SuperDuu/samsung-robot-2026/hardware/CAD/GB37.SLDPRT

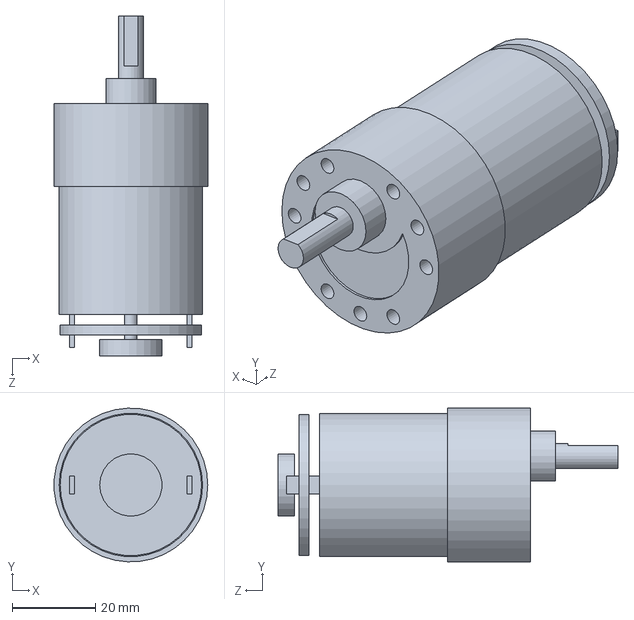
[picture p1: CAD file, 2026-10-31]
hardware/CAD/GB37.SLDPRT
36.9 x 37.0 x 81.8 mm
