SuperDuu/samsung-robot-2026/hardware/PCB/LINE_BOARD/uerlib/LIB_RPR-220/RPR-220/3D/RPR-220.stp

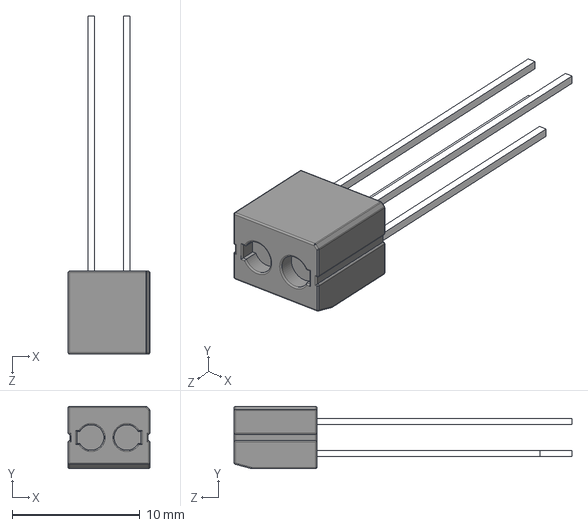
[picture p2: CAD file, 2026-10-31]
hardware/PCB/LINE_BOARD/uerlib/LIB_RPR-220/RPR-220/3D/RPR-220.stp
6.40 x 4.90 x 26.5 mm
