SuperDuu/samsung-robot-2026/hardware/CAD/Ga_GB37.SLDPRT

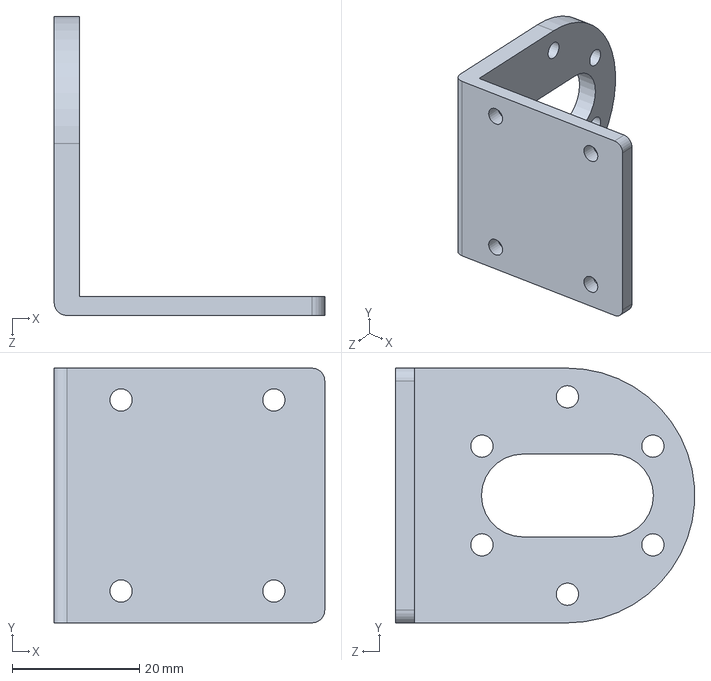
[picture p3: CAD file, 2026-10-31]
hardware/CAD/Ga_GB37.SLDPRT
42.5 x 40.0 x 47.0 mm
