SuperDuu/samsung-robot-2026/hardware/CAD/Onmi_58mm_OK.SLDPRT

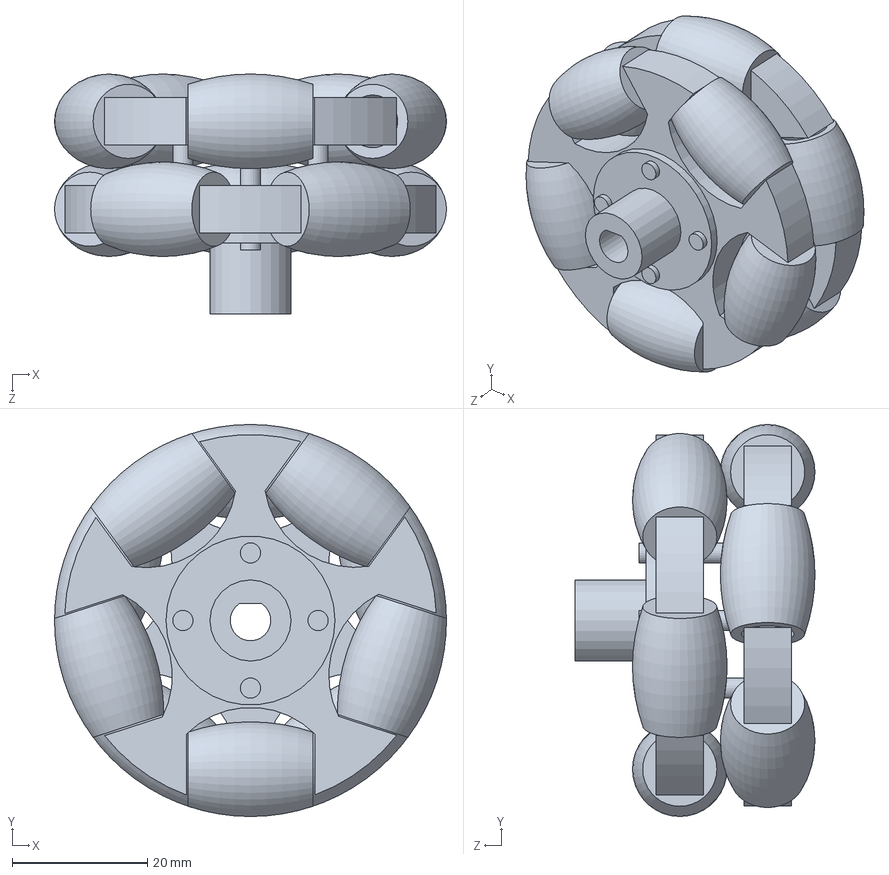
[picture p4: CAD file, 2026-10-31]
hardware/CAD/Onmi_58mm_OK.SLDPRT
58.0 x 58.0 x 35.5 mm
