SuperDuu/samsung-robot-2026/(list of files, cad)

Other CAD files:
hardware/LINE_BOARD/uerlib/LIB_RPR-220/RPR-220/Allegro/rpr220.psm
hardware/LINE_BOARD/uerlib/LIB_RPR-220/RPR-220/DEHDL/rpr_220/chips/chips.prt
hardware/PCB/LINE_BOARD/uerlib/LIB_RPR-220/RPR-220/DEHDL/rpr_220/chips/chips.prt
