SuperDuu/samsung-robot-2026/hardware/PCB/MainRB/MainRB.kicad_pcb

## KiCad design hardware/PCB/MainRB/MainRB.kicad_pcb (2026-10-31)

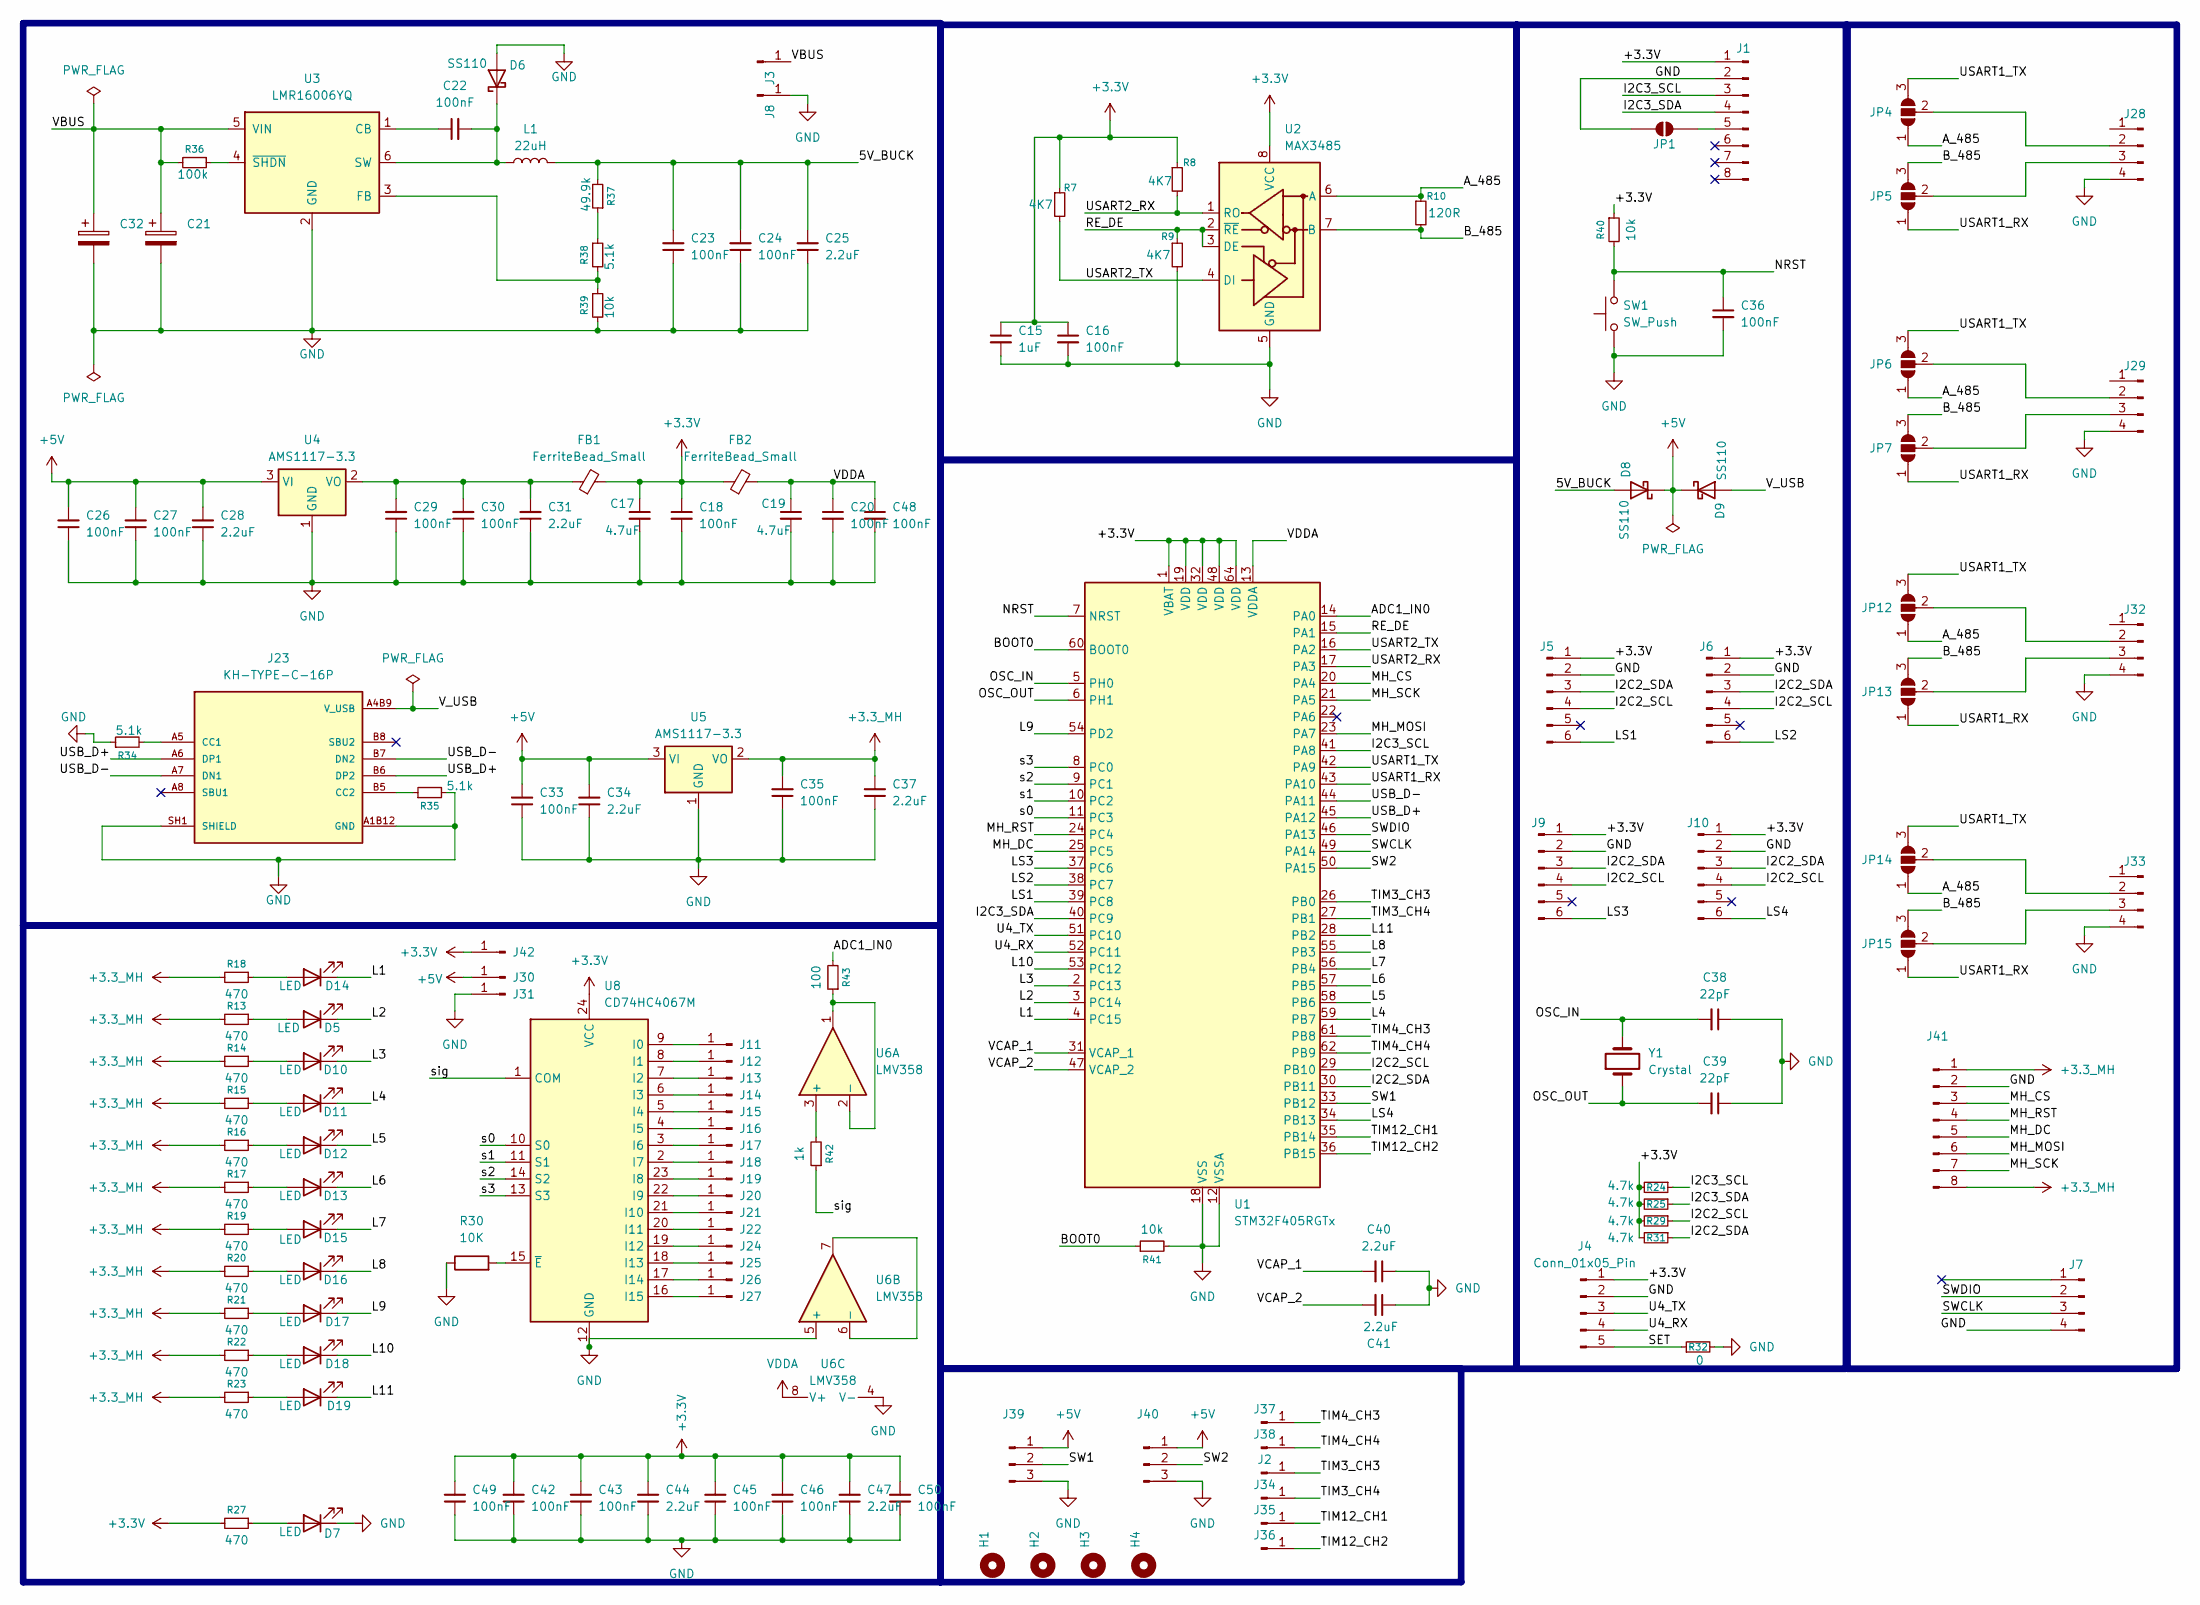
[picture p5: schematic MainRB.kicad_sch]

Parts:
C15: 1uF; C_0805_2012Metric_Pad1.18x1.45mm_HandSolder
C16, C18, C20, C22, C23, C24, C26, C27, C29, C30, C33, C35, C36, C42, C43, C45, C46, C48, C49, C50: 100nF; C_0805_2012Metric_Pad1.18x1.45mm_HandSolder
C17, C19: 4.7uF; C_0805_2012Metric_Pad1.18x1.45mm_HandSolder
C21, C32: C_Polarized; CP_Elec_10x10.5
C25, C28, C31, C34, C37, C40, C41, C44, C47: 2.2uF; C_0805_2012Metric_Pad1.18x1.45mm_HandSolder
C38, C39: 22pF; C_0805_2012Metric_Pad1.18x1.45mm_HandSolder
D5, D7, D10, D11, D12, D13, D14, D15, D16, D17, D18, D19: LED; LED_0805_2012Metric
D6, D8, D9: SS110; D_SMA
FB1, FB2: FerriteBead_Small; L_0603_1608Metric_Pad1.05x0.95mm_HandSolder
H1, H2, H3, H4: MountingHole; MountingHole_3.2mm_M3_ISO14580_Pad_TopBottom
J1: Conn_01x08_Pin; PinHeader_1x08_P2.54mm_Vertical
J2, J34, J35, J36, J37, J38: Conn_01x01_Pin; SolderWirePad_1x01_SMD_2x4mm
J3, J8: 24V_IN; SolderWirePad_1x01_SMD_4x8mm
J4: Conn_01x05_Pin; PinHeader_1x05_P2.54mm_Vertical
J5, J6, J9, J10: Conn_01x06_Pin; JST_XH_S6B-XH-A_1x06_P2.50mm_Horizontal
J7: Conn_01x04_Pin; JST_XH_B4B-XH-A_1x04_P2.50mm_Vertical
J11, J12, J13, J14, J15, J16, J17, J18, J19, J20, J21, J22, J24, J25, J26, J27, J30, J31, J42: Conn_01x01_Pin; SolderWirePad_1x01_SMD_1x2mm
J23: KH-TYPE-C-16P; KINGHELM_KH-TYPE-C-16P; PARTREV A0
J28, J29, J32, J33: Conn_01x04_Pin; JST_XH_S4B-XH-A-1_1x04_P2.50mm_Horizontal
J39, J40: Conn_01x03_Pin; JST_XH_B3B-XH-A_1x03_P2.50mm_Vertical
J41: Conn_01x08_Pin; JST_XH_B8B-XH-A_1x08_P2.50mm_Vertical
JP1: SolderJumper_2_Open; SolderJumper-2_P1.3mm_Open_Pad1.0x1.5mm
JP4, JP5, JP6, JP7, JP12, JP13, JP14, JP15: SolderJumper_3_Open; SolderJumper-3_P1.3mm_Open_RoundedPad1.0x1.5mm_NumberLabels
L1: 22uH; L_TracoPower_TCK-047_5.2x5.8mm
R7, R8, R9: 4K7; R_0805_2012Metric_Pad1.20x1.40mm_HandSolder
R10: 120R; R_0805_2012Metric_Pad1.20x1.40mm_HandSolder
R13, R14, R15, R16, R17, R18, R19, R20, R21, R22, R23, R27: 470; R_0805_2012Metric
R24, R25, R29, R31: 4.7k; R_0805_2012Metric
R30: 10K; R_0805_2012Metric
R32: 0; R_0805_2012Metric
R34, R35, R38: 5.1k; R_0805_2012Metric
R36: 100k; R_0805_2012Metric
R37: 49.9k; R_0805_2012Metric
R39, R40, R41: 10k; R_0805_2012Metric
R42: 1k; R_0805_2012Metric
R43: 100; R_0805_2012Metric
SW1: SW_Push; SW_Tactile_SPST_NO_Straight_CK_PTS636Sx25SMTRLFS
U1: STM32F405RGTx; LQFP-64_10x10mm_P0.5mm
U2: MAX3485; SOIC-8_3.9x4.9mm_P1.27mm
U3: LMR16006YQ; SOT-23-6
U4, U5: AMS1117-3.3; SOT-223-3_TabPin2
U6: LMV358; SOIC-8_3.9x4.9mm_P1.27mm
U8: CD74HC4067M; SOIC-24W_7.5x15.4mm_P1.27mm
Y1: Crystal; Crystal_HC49-4H_Vertical

Connections:
+3.3V: C15.1, C16.1, C17.1, C18.1, C42.2, C43.2, C44.2, C45.2, C46.2, C47.2, C49.2, C50.2, FB1.2, FB2.1, J1.1, J4.1, J5.1, J6.1, J9.1, J10.1, J42.1 (Pin_1_1), R7.1, R8.1, R24.2, R25.2, R27.2, R29.2, R31.2, R40.1, U1.1 (VBAT), U1.19 (VDD), U1.32 (VDD), U1.48 (VDD), U1.64 (VDD), U2.8 (VCC), U8.24 (VCC)
+3.3_MH: C35.2, C37.2, J41.1, J41.8, R13.2, R14.2, R15.2, R16.2, R17.2, R18.2, R19.2, R20.2, R21.2, R22.2, R23.2, U5.2 (VO)
+5V: C26.2, C27.2, C28.2, C33.2, C34.2, D8.1 (K), D9.1 (K), J30.1 (Pin_1_1), J39.1, J40.1, U4.3 (VI), U5.3 (VI)
/5V_BUCK: C23.2, C24.2, C25.2, D8.2 (A), L1.2, R37.2
/ADC1_IN0: R43.2, U1.14 (PA0)
/A_485: JP4.1 (A), JP6.1 (A), JP12.1 (A), JP14.1 (A), R10.1, U2.6 (A)
/BOOT0: R41.1, U1.60 (BOOT0)
/B_485: JP5.3 (B), JP7.3 (B), JP13.3 (B), JP15.3 (B), R10.2, U2.7 (B)
/I2C2_SCL: J5.4, J6.4, J9.4, J10.4, R29.1, U1.29 (PB10)
/I2C2_SDA: J5.3, J6.3, J9.3, J10.3, R31.1, U1.30 (PB11)
/I2C3_SCL: J1.3, R24.1, U1.41 (PA8)
/I2C3_SDA: J1.4, R25.1, U1.40 (PC9)
/L1: D14.1 (K), U1.4 (PC15)
/L2: D5.1 (K), U1.3 (PC14)
/L3: D10.1 (K), U1.2 (PC13)
/L4: D11.1 (K), U1.59 (PB7)
/L5: D12.1 (K), U1.58 (PB6)
/L6: D13.1 (K), U1.57 (PB5)
/L7: D15.1 (K), U1.56 (PB4)
/L8: D16.1 (K), U1.55 (PB3)
/L9: D17.1 (K), U1.54 (PD2)
/L10: D18.1 (K), U1.53 (PC12)
/L11: D19.1 (K), U1.28 (PB2)
/LS1: J5.6, U1.39 (PC8)
/LS2: J6.6, U1.38 (PC7)
/LS3: J9.6, U1.37 (PC6)
/LS4: J10.6, U1.34 (PB13)
/MH_CS: J41.3, U1.20 (PA4)
/MH_DC: J41.5, U1.25 (PC5)
/MH_MOSI: J41.6, U1.23 (PA7)
/MH_RST: J41.4, U1.24 (PC4)
/MH_SCK: J41.7, U1.21 (PA5)
/NRST: C36.1, R40.2, SW1.2, U1.7 (NRST)
/OSC_IN: C38.2, U1.5 (PH0), Y1.2
/OSC_OUT: C39.2, U1.6 (PH1), Y1.1
/RE_DE: R9.1, U1.15 (PA1), U2.2 (~RE), U2.3 (DE)
/SET: J4.5, R32.1
/SW1: J39.2, U1.33 (PB12)
/SW2: J40.2, U1.50 (PA15)
/SWCLK: J7.3, U1.49 (PA14)
/SWDIO: J7.2, U1.46 (PA13)
/TIM3_CH3: J2.1 (Pin_1_1), U1.26 (PB0)
/TIM3_CH4: J34.1 (Pin_1_1), U1.27 (PB1)
/TIM4_CH3: J37.1 (Pin_1_1), U1.61 (PB8)
/TIM4_CH4: J38.1 (Pin_1_1), U1.62 (PB9)
/TIM12_CH1: J35.1 (Pin_1_1), U1.35 (PB14)
/TIM12_CH2: J36.1 (Pin_1_1), U1.36 (PB15)
/U4_RX: J4.4, U1.52 (PC11)
/U4_TX: J4.3, U1.51 (PC10)
/USART1_RX: JP5.1 (A), JP7.1 (A), JP13.1 (A), JP15.1 (A), U1.43 (PA10)
/USART1_TX: JP4.3 (B), JP6.3 (B), JP12.3 (B), JP14.3 (B), U1.42 (PA9)
/USART2_RX: R8.2, U1.17 (PA3), U2.1 (RO)
/USART2_TX: R7.2, U1.16 (PA2), U2.4 (DI)
/USB_D+: J23.A6 (DP1), J23.B6 (DP2), U1.45 (PA12)
/USB_D-: J23.A7 (DN1), J23.B7 (DN2), U1.44 (PA11)
/VBUS: C21.1, C32.1, J3.1 (Pin_1_1), R36.2, U3.5 (VIN)
/VCAP_1: C40.2, U1.31 (VCAP_1)
/VCAP_2: C41.2, U1.47 (VCAP_2)
/s0: U1.11 (PC3), U8.10 (S0)
/s1: U1.10 (PC2), U8.11 (S1)
/s2: U1.9 (PC1), U8.14 (S2)
/s3: U1.8 (PC0), U8.13 (S3)
/sig: R42.1, U8.1 (COM)
GND: C15.2, C16.2, C17.2, C18.2, C19.2, C20.2, C21.2, C23.1, C24.1, C25.1, C26.1, C27.1, C28.1, C29.1, C30.1, C31.1, C32.2, C33.1, C34.1, C35.1, C36.2, C37.1, C38.1, C39.1, C40.1, C41.1, C42.1, C43.1, C44.1, C45.1, C46.1, C47.1, C48.2, C49.1, C50.1, D6.2 (A), D7.1 (K), J1.2, J4.2, J5.2, J6.2, J7.4, J8.1 (Pin_1_1), J9.2, J10.2, J23.A1B12 (GND), J23.A12B1 (GND), J23.SH1 (SHIELD), J23.SH2 (SHIELD), J23.SH3 (SHIELD), J23.SH4 (SHIELD), J28.4, J29.4, J31.1 (Pin_1_1), J32.4, J33.4, J39.3, J40.3, J41.2, JP1.1 (A), R9.2, R30.1, R32.2, R34.1, R35.2, R39.2, R41.2, SW1.1, U1.12 (VSSA), U1.18 (VSS), U1.63 (VSS), U2.5 (GND), U3.2 (GND), U4.1 (GND), U5.1 (GND), U6.4 (V-), U6.5 (+), U8.12 (GND)
unnamed: D5.2 (A), R13.1
unnamed: C22.2, D6.1 (K), L1.1, U3.6 (SW)
unnamed: D7.2 (A), R27.1
unnamed: D10.2 (A), R14.1
unnamed: D11.2 (A), R15.1
unnamed: D12.2 (A), R16.1
unnamed: D13.2 (A), R17.1
unnamed: D14.2 (A), R18.1
unnamed: D15.2 (A), R19.1
unnamed: D16.2 (A), R20.1
unnamed: D17.2 (A), R21.1
unnamed: D18.2 (A), R22.1
unnamed: D19.2 (A), R23.1
unnamed: J1.5, JP1.2 (B)
unnamed: J11.1 (Pin_1_1), U8.9 (I0)
unnamed: J12.1 (Pin_1_1), U8.8 (I1)
unnamed: J13.1 (Pin_1_1), U8.7 (I2)
unnamed: J14.1 (Pin_1_1), U8.6 (I3)
unnamed: J15.1 (Pin_1_1), U8.5 (I4)
unnamed: J16.1 (Pin_1_1), U8.4 (I5)
unnamed: J17.1 (Pin_1_1), U8.3 (I6)
unnamed: J18.1 (Pin_1_1), U8.2 (I7)
unnamed: J19.1 (Pin_1_1), U8.23 (I8)
unnamed: J20.1 (Pin_1_1), U8.22 (I9)
unnamed: J21.1 (Pin_1_1), U8.21 (I10)
unnamed: J22.1 (Pin_1_1), U8.20 (I11)
unnamed: J23.A5 (CC1), R34.2
unnamed: J23.B5 (CC2), R35.1
unnamed: J24.1 (Pin_1_1), U8.19 (I12)
unnamed: J25.1 (Pin_1_1), U8.18 (I13)
unnamed: J26.1 (Pin_1_1), U8.17 (I14)
unnamed: J27.1 (Pin_1_1), U8.16 (I15)
unnamed: J28.2, JP4.2 (C)
unnamed: J28.3, JP5.2 (C)
unnamed: J29.2, JP6.2 (C)
unnamed: J29.3, JP7.2 (C)
unnamed: J32.2, JP12.2 (C)
unnamed: J32.3, JP13.2 (C)
unnamed: J33.2, JP14.2 (C)
unnamed: J33.3, JP15.2 (C)
unnamed: R37.1, R38.1
unnamed: C22.1, U3.1 (CB)
unnamed: R38.2, R39.1, U3.3 (FB)
unnamed: R36.1, U3.4 (~SHDN)
unnamed: C29.2, C30.2, C31.2, FB1.1, U4.2 (VO)
unnamed: R42.2, U6.3 (+)
unnamed: R43.1, U6.1, U6.2 (-)
unnamed: U6.6 (-), U6.7
unnamed: R30.2, U8.15 (~E)
VDDA: C19.1, C20.1, C48.1, FB2.2, U1.13 (VDDA), U6.8 (V+)
V_USB: D9.2 (A), J23.A4B9 (V_USB), J23.A9B4 (V_USB)

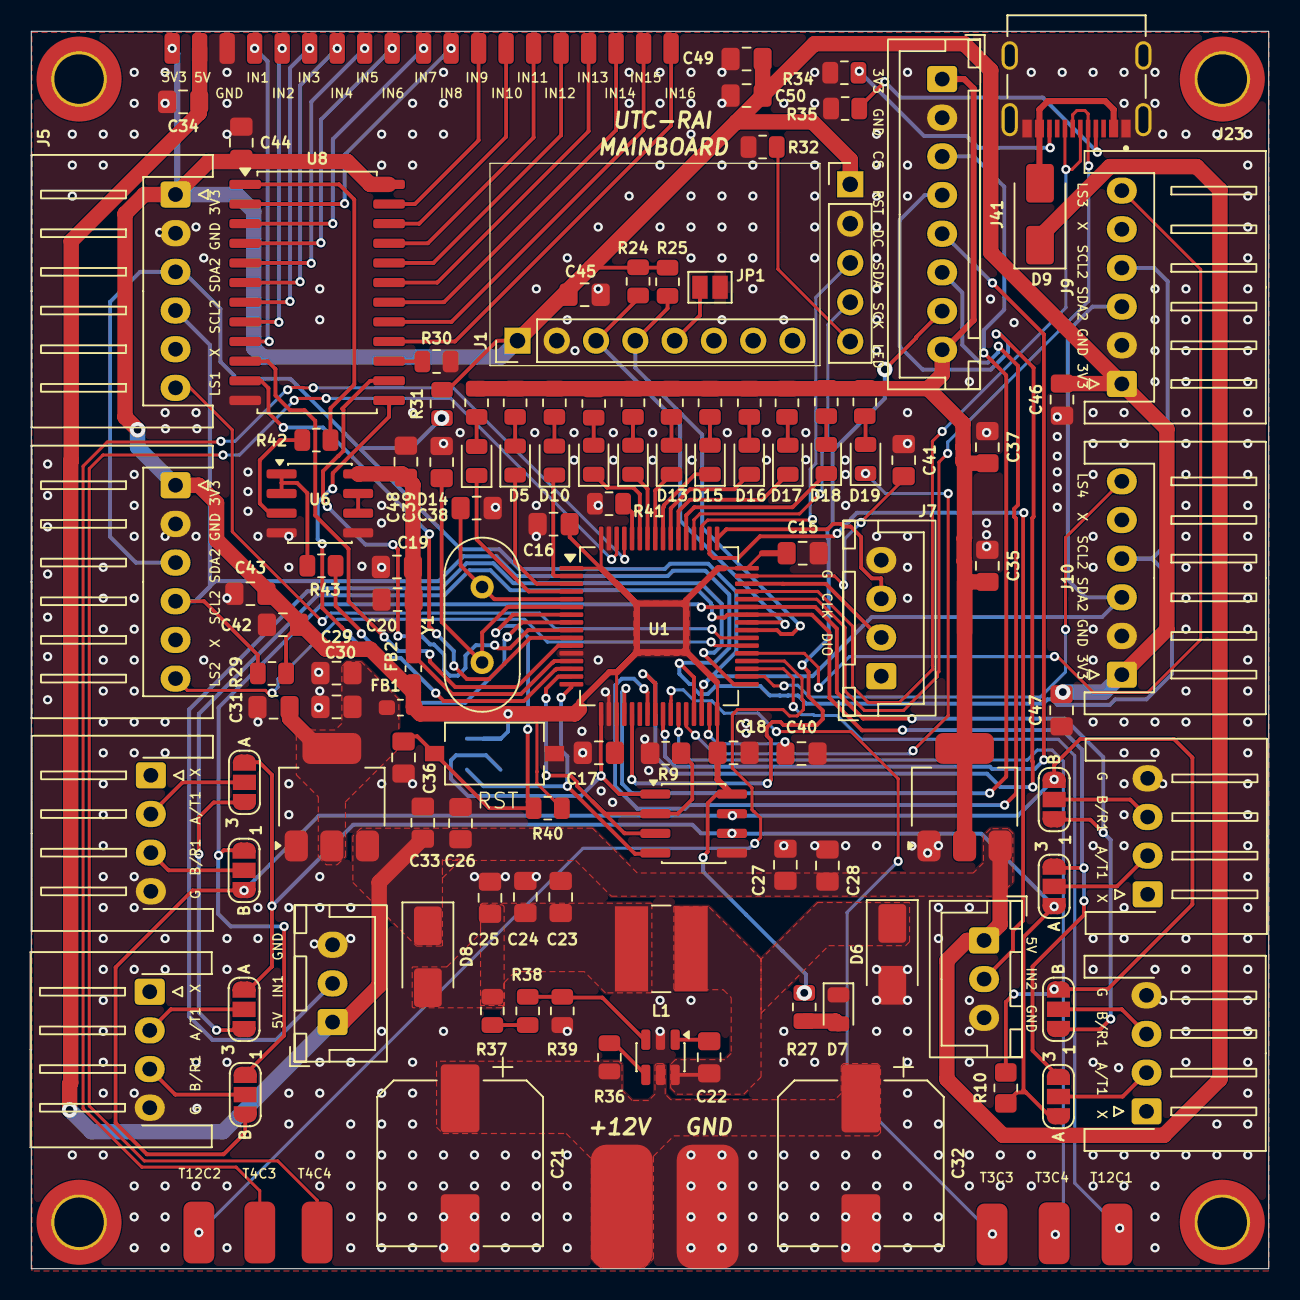
[picture p6: board MainRB.kicad_pcb from above]

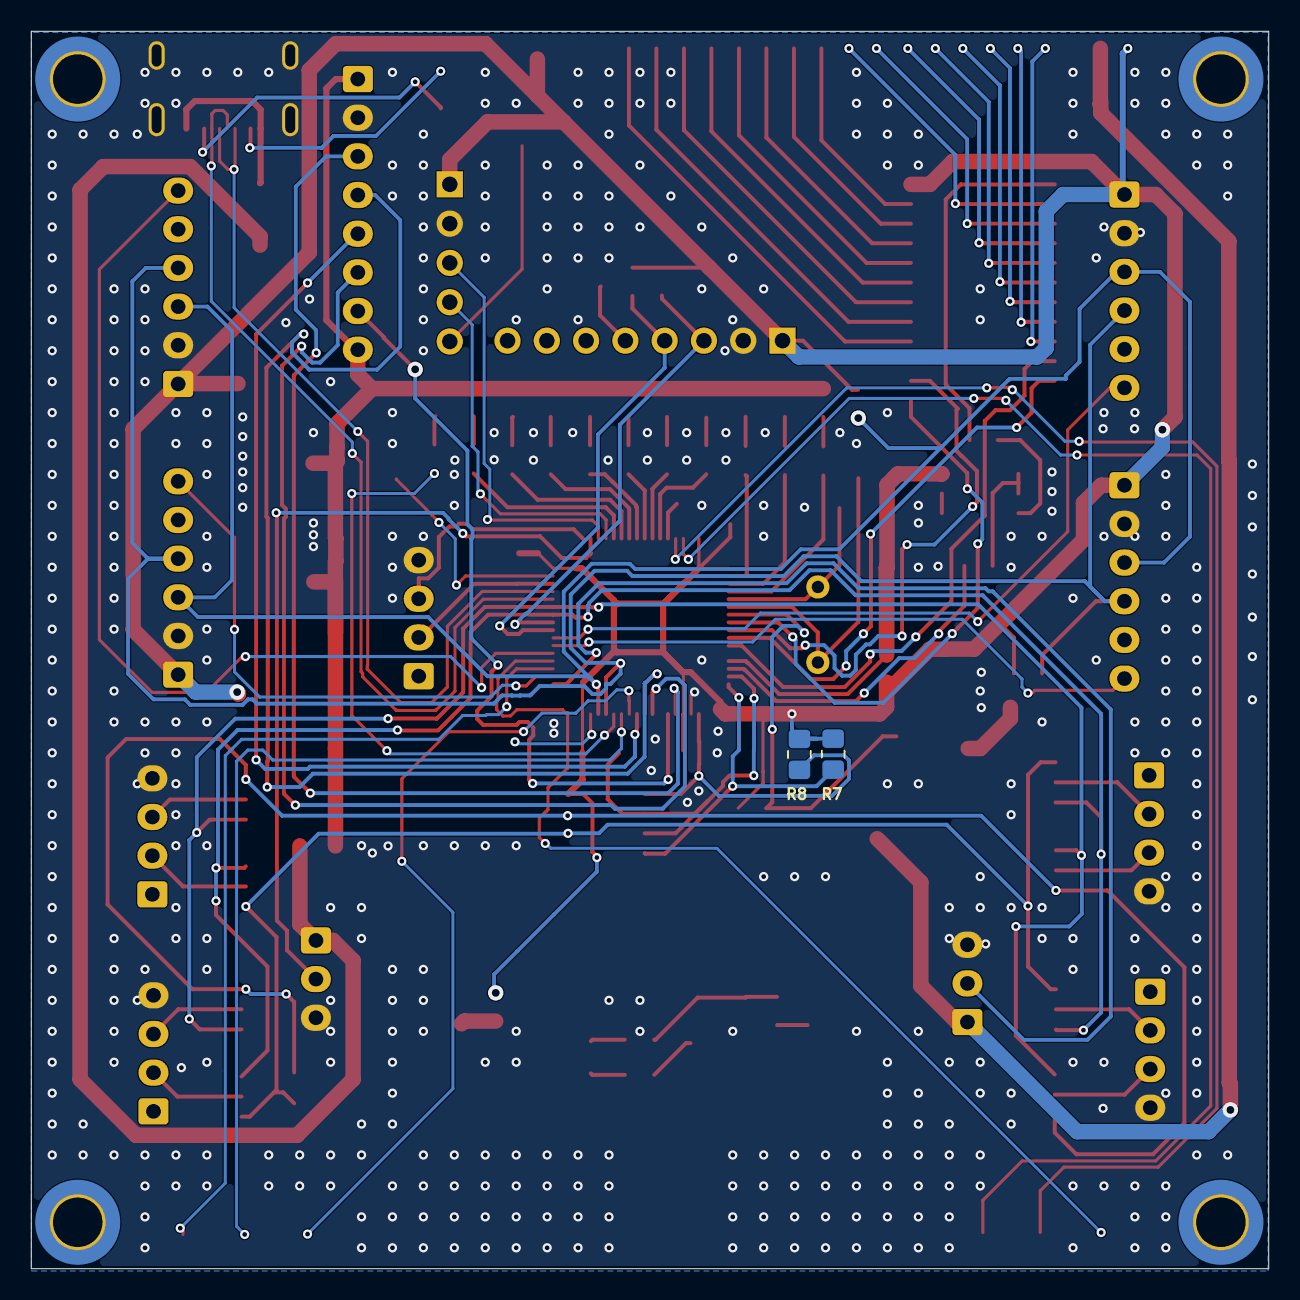
[picture p7: board MainRB.kicad_pcb from below]

Board: 2 copper layers, 80.0 x 80.0 mm, 150 parts (2 on the bottom side), 115 nets.
