SuperDuu/samsung-robot-2026/hardware/PCB/HB_RBC/HB_RBC.kicad_pcb

## KiCad design hardware/PCB/HB_RBC/HB_RBC.kicad_pcb (2026-10-31)

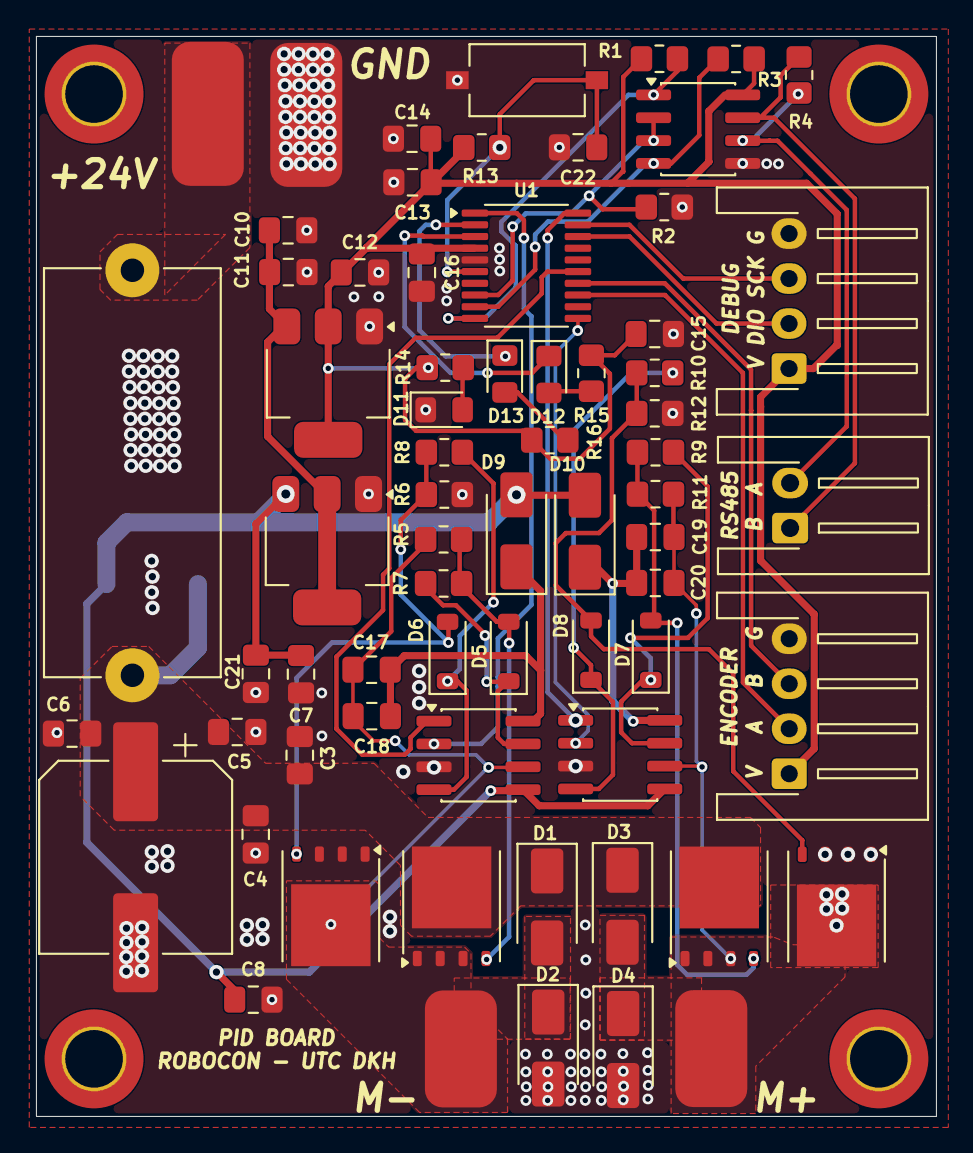
[picture p8: board HB_RBC.kicad_pcb from above]

Board: 2 copper layers, 50.0 x 60.0 mm, 73 parts (1 on the bottom side), 37 nets.

Parts:
C2: 50v_220uF; CP_Elec_10x10.5
C3, C7, C10, C12: 10uF; C_0805_2012Metric_Pad1.18x1.45mm_HandSolder
C4, C15, C17, C19: 1uF; C_0805_2012Metric_Pad1.18x1.45mm_HandSolder
C5, C6, C8, C11, C13, C14, C16, C18, C20, C21, C22: 100nF; C_0805_2012Metric_Pad1.18x1.45mm_HandSolder
D1: SS310; D_SMA
D2, D3, D4: D_Schottky; D_SMA
D5, D6, D7, D8: 1N4148W; D_SOD-123
D9, D10: SS110; D_SMA
D11, D12, D13: LED; LED_0805_2012Metric_Pad1.15x1.40mm_HandSolder
F1: Fuse; Fuseholder_Cylinder-5x20mm_Schurter_0031_8201_Horizontal_Op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
H1, H2, H3, H4: MountingHole; MountingHole_3.2mm_M3_ISO14580_Pad_TopBottom
J1: M+; SolderWirePad_1x01_SMD_4x8mm
J2: M-; SolderWirePad_1x01_SMD_4x8mm
J3: 24V_IN; SolderWirePad_1x01_SMD_4x8mm
J4: Conn_01x01_Pin; SolderWirePad_1x01_SMD_4x8mm
J5: Conn_01x02_Pin; JST_XH_S2B-XH-A-1_1x02_P2.50mm_Horizontal
J6, J7: Conn_01x04_Pin; JST_XH_S4B-XH-A-1_1x04_P2.50mm_Horizontal
Q1, Q2, Q3, Q4: BSC040N10NS5; TDSON-8-1
R1, R2, R3, R13: 4K7; R_0805_2012Metric_Pad1.20x1.40mm_HandSolder
R4: 120R; R_0805_2012Metric_Pad1.20x1.40mm_HandSolder
R5, R6, R11, R12: 1M; R_0805_2012Metric_Pad1.20x1.40mm_HandSolder
R7, R8, R9, R10: 10R; R_0805_2012Metric_Pad1.20x1.40mm_HandSolder
R14, R15, R16: 470; R_0805_2012Metric_Pad1.20x1.40mm_HandSolder
SW1: SW_Push; SW_Tactile_SPST_NO_Straight_CK_PTS636Sx25SMTRLFS
U1: STM32G030F6Px; TSSOP-20_4.4x6.5mm_P0.65mm
U2: MAX3485; SOIC-8_3.9x4.9mm_P1.27mm
U4: L7815; TO-263-3_TabPin2
U5: AMS1117-5.0; SOT-223-3_TabPin2
U6: AMS1117-3.3; SOT-223-3_TabPin2
U7, U8: IR2184; SOIC-8_3.9x4.9mm_P1.27mm

Connections:
+3.3V: C12.1, C13.1, C14.1, C15.1, C16.1, J6.1, J7.1, R1.1, R3.1, R13.1, R14.1, R15.1, R16.1, U1.4 (VDD), U2.8 (VCC), U6.2 (VO)
+5V: C10.1, C11.1, U5.2 (VO), U6.3 (VI)
+15V: C7.1, C8.1, C21.1, D9.2 (A), D10.2 (A), U4.3 (OUT), U5.3 (VI), U7.5 (VCC), U8.5 (VCC)
+24V: C2.1, C3.1, C4.1, C5.1, C6.1, D1.1 (K), D3.1 (K), F1.2, Q1.5 (D), Q4.5 (D), U4.1 (IN)
+24V_IN: F1.1, J3.1 (Pin_1_1)
/A: J6.2, U1.13 (PA6)
/A_485: J5.2, R4.1, U2.6 (A)
/B: J6.3, U1.14 (PA7)
/B_485: J5.1, R4.2, U2.7 (B)
/LED1: D12.1 (K), U1.3 (PC15)
/LED2: D13.1 (K), U1.2 (PB9/PC14)
/NRST: C22.1, R13.2, SW1.2, U1.6 (NRST)
/PWM_T1C1: U1.15 (PA8/PB0/PB1/PB2), U7.1 (IN)
/PWM_T1C2: U1.20 (PB3/PB4/PB5/PB6), U8.1 (IN)
/RE_DE: R2.1, U1.8 (PA1), U2.2 (~RE), U2.3 (DE)
/S: U1.1 (PB7/PB8), U7.2 (~SD)
/S2: U1.11 (PA4), U8.2 (~SD)
/SWCLK: J7.3, U1.19 (PA14/PA15)
/SWDIO: J7.2, U1.18 (PA13)
/U2_RX: R1.2, U1.10 (PA3), U2.1 (RO)
/U2_TX: R3.2, U1.9 (PA2), U2.4 (DI)
GND: C2.2, C3.2, C4.2, C5.2, C6.2, C7.2, C8.2, C10.2, C11.2, C12.2, C13.2, C14.2, C15.2, C16.2, C21.2, C22.2, D2.2 (A), D4.2 (A), D11.1 (K), J4.1 (Pin_1_1), J6.4, J7.4, Q2.1 (S), Q2.2 (S), Q2.3 (S), Q3.1 (S), Q3.2 (S), Q3.3 (S), R2.2, R6.2, R12.2, SW1.1, U1.5 (VSS), U2.5 (GND), U4.2 (GND), U5.1 (GND), U6.1 (GND), U7.3 (COM), U8.3 (COM)
unnamed: C17.2, C18.2, D1.2 (A), D2.1 (K), J2.1 (Pin_1_1), Q1.1 (S), Q1.2 (S), Q1.3 (S), Q2.5 (D), R5.2, U7.6 (VS)
unnamed: C19.2, C20.2, D3.2 (A), D4.1 (K), J1.1 (Pin_1_1), Q3.5 (D), Q4.1 (S), Q4.2 (S), Q4.3 (S), R11.2, U8.6 (VS)
unnamed: D5.2 (A), Q1.4 (G), R5.1, R7.2
unnamed: D5.1 (K), R7.1, U7.7 (HO)
unnamed: D6.2 (A), Q2.4 (G), R6.1, R8.2
unnamed: D6.1 (K), R8.1, U7.4 (LO)
unnamed: D7.2 (A), Q4.4 (G), R9.2, R11.1
unnamed: D7.1 (K), R9.1, U8.7 (HO)
unnamed: D8.2 (A), Q3.4 (G), R10.2, R12.1
unnamed: D8.1 (K), R10.1, U8.4 (LO)
unnamed: C17.1, C18.1, D9.1 (K), U7.8 (VB)
unnamed: C19.1, C20.1, D10.1 (K), U8.8 (VB)
unnamed: D11.2 (A), R14.2
unnamed: D12.2 (A), R15.2
unnamed: D13.2 (A), R16.2
