SuperDuu/samsung-robot-2026/hardware/LINE_BOARD/mach_do_line/mach_do_line.kicad_pcb

## KiCad design hardware/LINE_BOARD/mach_do_line/mach_do_line.kicad_pcb (2026-10-13)

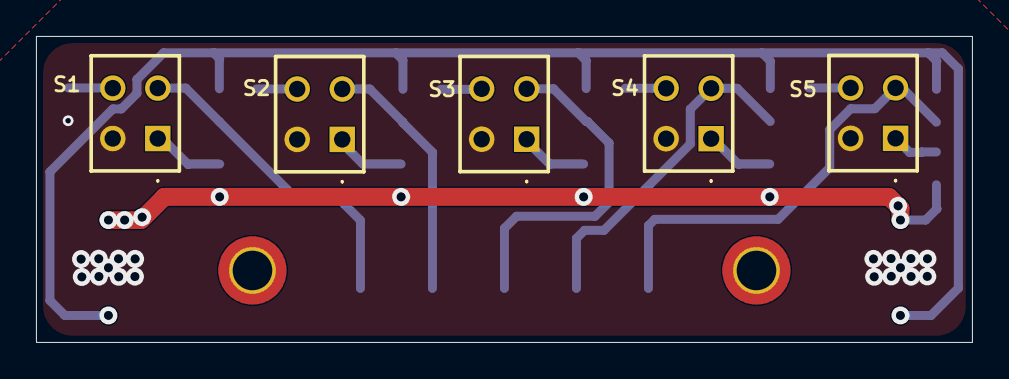
[picture p9: board mach_do_line.kicad_pcb from above]

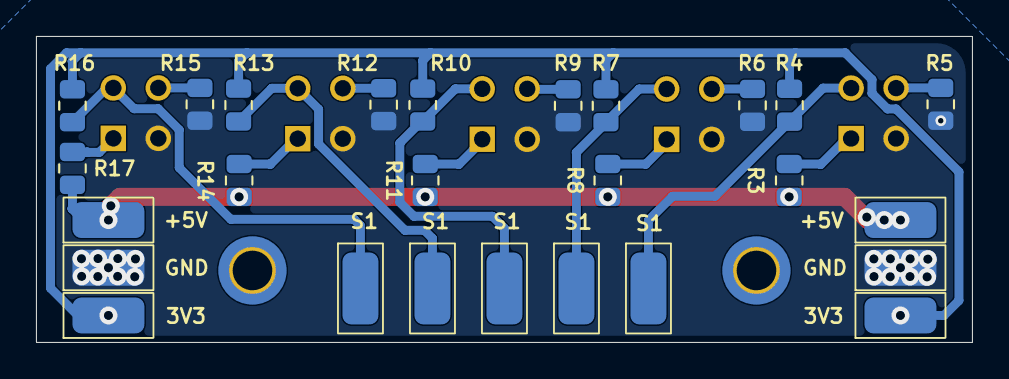
[picture p10: board mach_do_line.kicad_pcb from below]

Board: 2 copper layers, 52.0 x 17.0 mm, 33 parts (26 on the bottom side), 18 nets.

Parts:
3V3, 3V3#2: Conn_01x01_Pin; PAD-2x4mm-SMD
+5V, +5V#2: Conn_01x01_Pin; PAD-2x4mm-SMD
GND: Conn_01x01_Pin; PAD-2x4mm-SMD
GND#2: Conn_01x01_Pin; PAD-2x4mm-SMD
H1, H2: MountingHole; MountingHole_2.2mm_M2_ISO14580_Pad_TopBottom
J2, J10, J11, J12, J18: Conn_01x01_Pin; PAD-2x4mm-SMD
R3, R8, R11, R14, R17: 220R; R_0805_2012Metric
R4, R7, R10, R13, R16: 10K; R_0805_2012Metric
R5, R6, R9, R12, R15: 100R; R_0805_2012Metric
S1, S2, S3, S4, S5: RPR-220; RPR220

Connections:
+3V3: 3V3.1 (Pin_1_1), 3V3#2.1 (Pin_1_1), R4.2, R7.2, R10.2, R13.2, R16.2
+5V: +5V.1 (Pin_1_1), +5V#2.1 (Pin_1_1), R3.1, R8.1, R11.1, R14.1, R17.1
/s1: J2.1 (Pin_1_1), R4.1, S1.4 (C)
/s2: J10.1 (Pin_1_1), R7.1, S2.4 (C)
/s3: J11.1 (Pin_1_1), R10.1, S3.4 (C)
/s4: J12.1 (Pin_1_1), R13.1, S4.4 (C)
/s5: J18.1 (Pin_1_1), R16.1, S5.4 (C)
GND: GND.1 (Pin_1_1), GND#2.1 (Pin_1_1), R5.2, R6.2, R9.2, R12.2, R15.2, S1.2 (K), S2.2 (K), S3.2 (K), S4.2 (K), S5.2 (K)
unnamed: R3.2, S1.1 (A)
unnamed: R5.1, S1.3 (E)
unnamed: R8.2, S2.1 (A)
unnamed: R6.1, S2.3 (E)
unnamed: R11.2, S3.1 (A)
unnamed: R9.1, S3.3 (E)
unnamed: R14.2, S4.1 (A)
unnamed: R12.1, S4.3 (E)
unnamed: R17.2, S5.1 (A)
unnamed: R15.1, S5.3 (E)
