SuperDuu/samsung-robot-2026/MAIN_CONTROLLER/Indicator.kicad_sch

## KiCad design MAIN_CONTROLLER/Indicator.kicad_sch (2026-10-13)

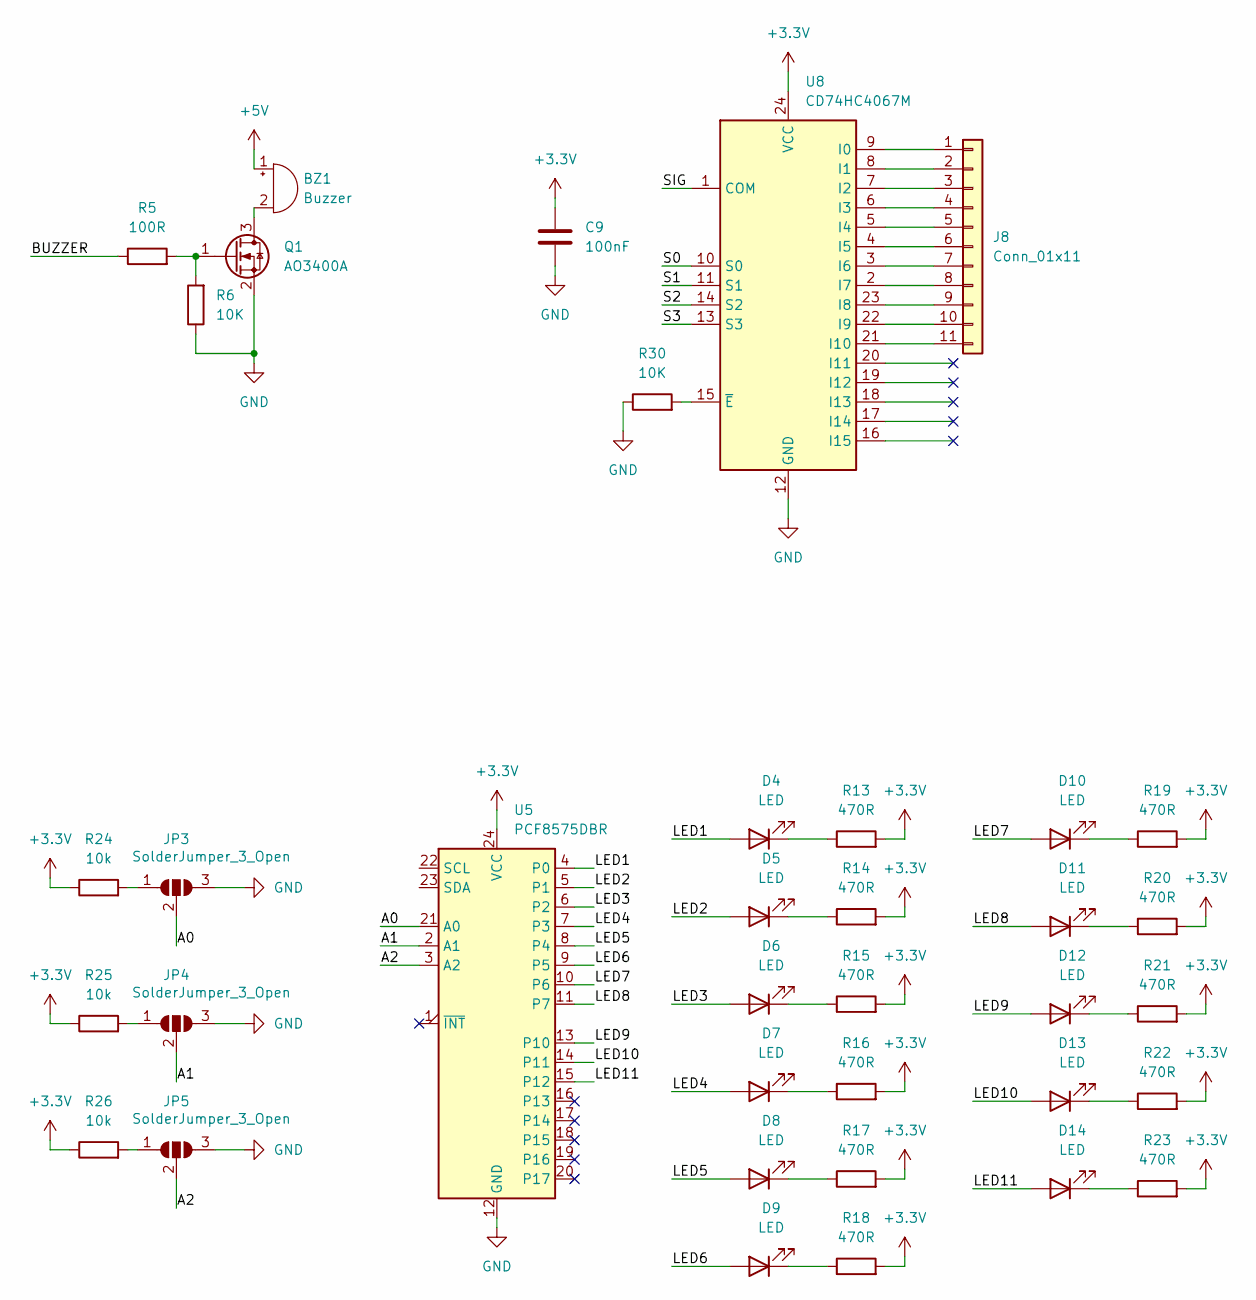
[picture p11: schematic Indicator.kicad_sch]

Parts:
BZ1: Buzzer
C9: 100nF
D4, D5, D6, D7, D8, D9, D10, D11, D12, D13, D14: LED
J8: Conn_01x11
JP3, JP4, JP5: SolderJumper_3_Open
Q1: AO3400A; SOT-23
R5: 100R
R6, R30: 10K
R13, R14, R15, R16, R17, R18, R19, R20, R21, R22, R23: 470R
R24, R25, R26: 10k
U5: PCF8575DBR; SSOP-24_5.3x8.2mm_P0.65mm
U8: CD74HC4067M; SOIC-24W_7.5x15.4mm_P1.27mm

Connections:
+3.3V: C9.1, R13.2, R14.2, R15.2, R16.2, R17.2, R18.2, R19.2, R20.2, R21.2, R22.2, R23.2, R24.1, R25.1, R26.1, U5.24 (VCC), U8.24 (VCC)
+5V: BZ1.1 (+)
A0: JP3.2 (C), U5.21 (A0)
A1: JP4.2 (C), U5.2 (A1)
A2: JP5.2 (C), U5.3 (A2)
BUZZER: R5.1
GND: C9.2, JP3.3 (B), JP4.3 (B), JP5.3 (B), Q1.2 (S), R6.1, R30.1, U5.12 (GND), U8.12 (GND)
LED1: D4.2 (A), U5.4 (P0)
LED2: D5.2 (A), U5.5 (P1)
LED3: D6.2 (A), U5.6 (P2)
LED4: D7.2 (A), U5.7 (P3)
LED5: D8.2 (A), U5.8 (P4)
LED6: D9.2 (A), U5.9 (P5)
LED7: D10.2 (A), U5.10 (P6)
LED8: D11.2 (A), U5.11 (P7)
LED9: D12.2 (A), U5.13 (P10)
LED10: D13.2 (A), U5.14 (P11)
LED11: D14.2 (A), U5.15 (P12)
unnamed: BZ1.2 (-), Q1.3 (D)
unnamed: D4.1 (K), R13.1
unnamed: D5.1 (K), R14.1
unnamed: D6.1 (K), R15.1
unnamed: D7.1 (K), R16.1
unnamed: D8.1 (K), R17.1
unnamed: D9.1 (K), R18.1
unnamed: D10.1 (K), R19.1
unnamed: D11.1 (K), R20.1
unnamed: D12.1 (K), R21.1
unnamed: D13.1 (K), R22.1
unnamed: D14.1 (K), R23.1
unnamed: J8.1, U8.9 (I0)
unnamed: J8.2, U8.8 (I1)
unnamed: J8.3, U8.7 (I2)
unnamed: J8.4, U8.6 (I3)
unnamed: J8.5, U8.5 (I4)
unnamed: J8.6, U8.4 (I5)
unnamed: J8.7, U8.3 (I6)
unnamed: J8.8, U8.2 (I7)
unnamed: J8.9, U8.23 (I8)
unnamed: J8.10, U8.22 (I9)
unnamed: J8.11, U8.21 (I10)
unnamed: JP3.1 (A), R24.2
unnamed: JP4.1 (A), R25.2
unnamed: JP5.1 (A), R26.2
unnamed: Q1.1 (G), R5.2, R6.2
unnamed: R30.2, U8.15 (~E)
S0: U8.10 (S0)
S1: U8.11 (S1)
S2: U8.14 (S2)
S3: U8.13 (S3)
SIG: U8.1 (COM)
