SuperDuu/samsung-robot-2026/hardware/MAIN_CONTROLLER/Power.kicad_sch

## KiCad design hardware/MAIN_CONTROLLER/Power.kicad_sch (2026-10-13)

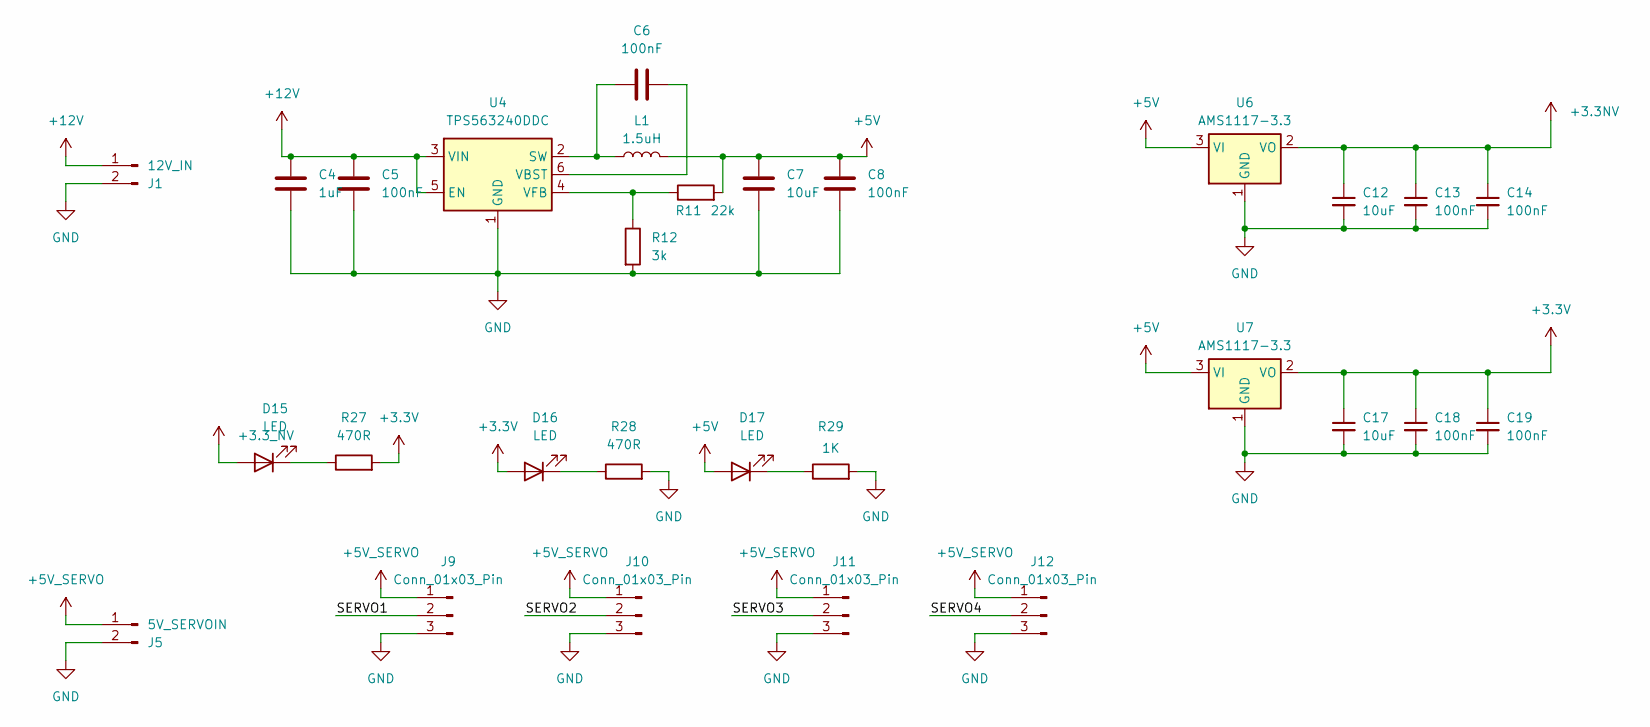
[picture p12: schematic Power.kicad_sch]

Parts:
C4: 1uF
C5, C6, C8: 100nF
C7: 10uF
C12, C17: 10uF; C_0805_2012Metric_Pad1.18x1.45mm_HandSolder
C13, C14, C18, C19: 100nF; C_0805_2012Metric_Pad1.18x1.45mm_HandSolder
D15, D16, D17: LED
J1: 12V_IN
J5: 5V_SERVOIN
J9, J10, J11, J12: Conn_01x03_Pin
L1: 1.5uH
R11: 22k
R12: 3k
R27, R28: 470R
R29: 1K
U4: TPS563240DDC; SOT-23-6
U6, U7: AMS1117-3.3; SOT-223-3_TabPin2

Connections:
+3.3NV: C12.1, C13.1, C14.1, U6.2 (VO)
+3.3V: C17.1, C18.1, C19.1, D16.2 (A), R27.2, U7.2 (VO)
+3.3_NV: D15.2 (A)
+5V: C7.1, C8.1, D17.2 (A), L1.2, R11.2, U6.3 (VI), U7.3 (VI)
+5V_SERVO: J5.1, J9.1, J10.1, J11.1, J12.1
+12V: C4.1, C5.1, J1.1, U4.3 (VIN), U4.5 (EN)
GND: C4.2, C5.2, C7.2, C8.2, C12.2, C13.2, C14.2, C17.2, C18.2, C19.2, J1.2, J5.2, J9.3, J10.3, J11.3, J12.3, R12.2, R28.2, R29.2, U4.1 (GND), U6.1 (GND), U7.1 (GND)
unnamed: C6.1, L1.1, U4.2 (SW)
unnamed: C6.2, U4.6 (VBST)
unnamed: D15.1 (K), R27.1
unnamed: D16.1 (K), R28.1
unnamed: D17.1 (K), R29.1
unnamed: R11.1, R12.1, U4.4 (VFB)
SERVO1: J9.2
SERVO2: J10.2
SERVO3: J11.2
SERVO4: J12.2
