SuperDuu/samsung-robot-2026/hardware/MAIN_CONTROLLER/_restore_backup_2026-10-13T14-17-59-498/Indicator.kicad_sch

## KiCad design hardware/MAIN_CONTROLLER/_restore_backup_2026-10-13T14-17-59-498/Indicator.kicad_sch (2026-10-13)

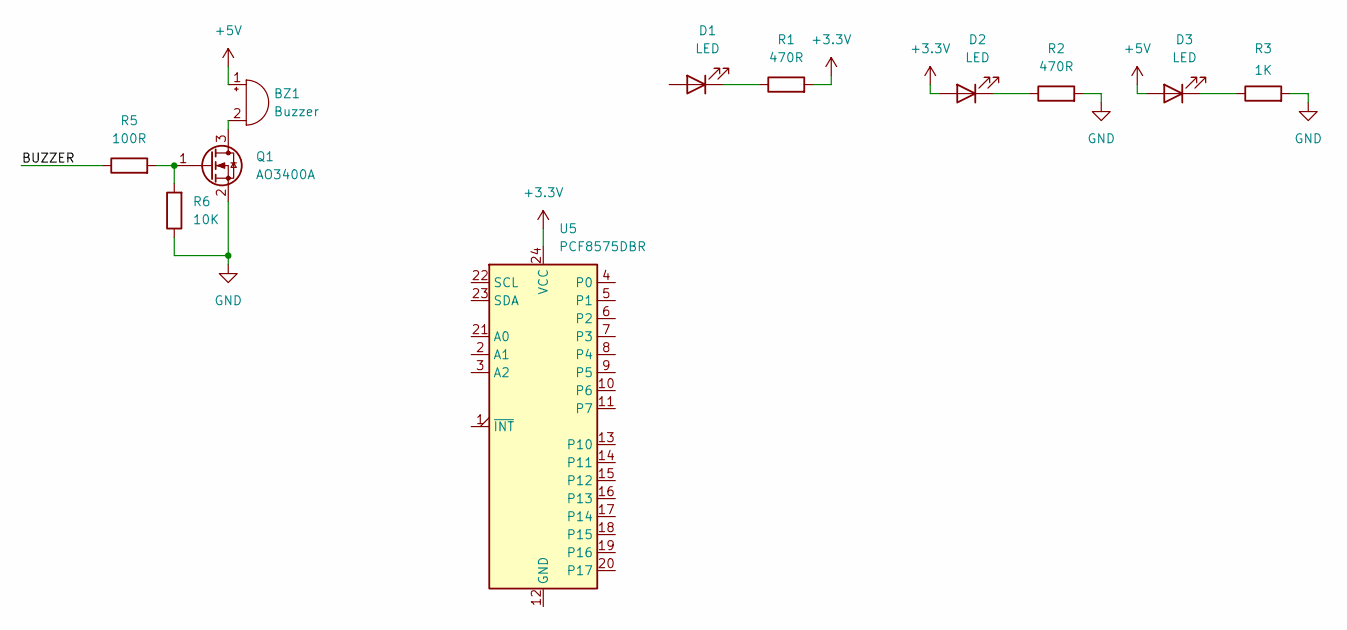
[picture p13: schematic Indicator.kicad_sch]

Parts:
BZ1: Buzzer
D1, D2, D3: LED
Q1: AO3400A; SOT-23
R1, R2: 470R
R3: 1K
R5: 100R
R6: 10K
U5: PCF8575DBR; SSOP-24_5.3x8.2mm_P0.65mm

Connections:
+3.3V: D2.2 (A), R1.2, U5.24 (VCC)
+5V: BZ1.1 (+), D3.2 (A)
BUZZER: R5.1
GND: Q1.2 (S), R2.2, R3.2, R6.1
unnamed: BZ1.2 (-), Q1.3 (D)
unnamed: D1.1 (K), R1.1
unnamed: D2.1 (K), R2.1
unnamed: D3.1 (K), R3.1
unnamed: Q1.1 (G), R5.2, R6.2
