SuperDuu/samsung-robot-2026/hardware/PCB/LINE_BOARD/mach_do_line/mach_do_line.kicad_sch

## KiCad design hardware/PCB/LINE_BOARD/mach_do_line/mach_do_line.kicad_sch (2026-10-31)

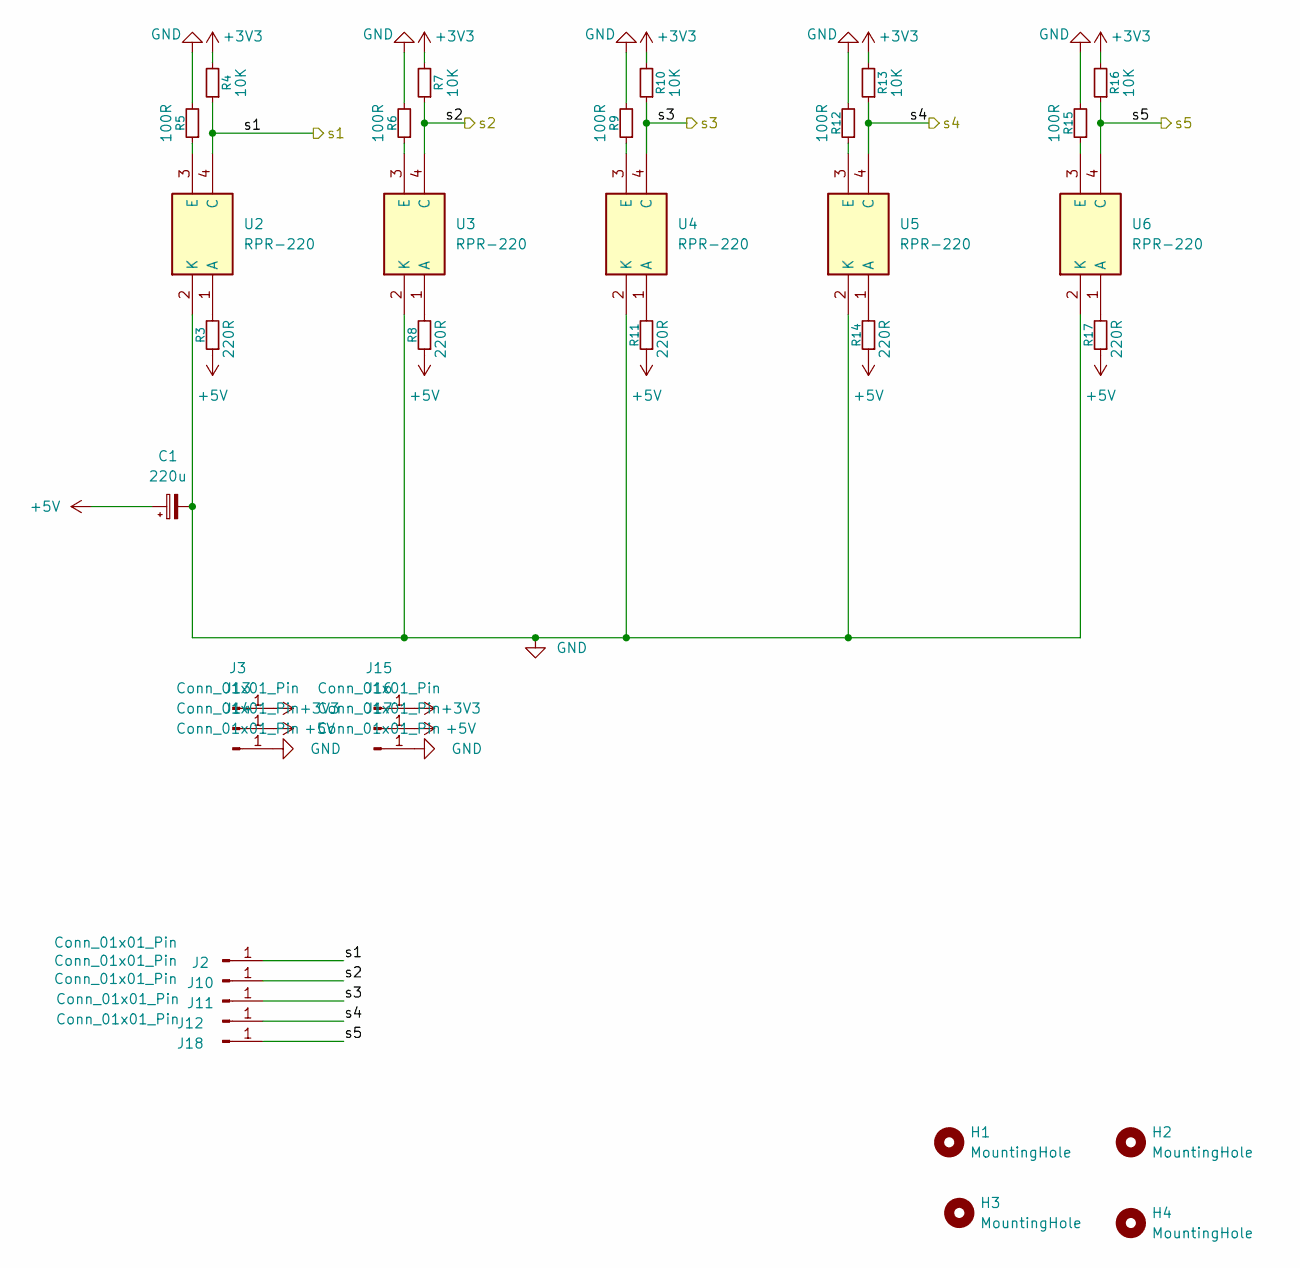
[picture p14: schematic mach_do_line.kicad_sch]

Parts:
C1: 220u; CP_Elec_4x3
H1, H2, H3, H4: MountingHole; MountingHole_2.2mm_M2_ISO14580_Pad_TopBottom
J2, J3, J10, J11, J12, J13, J14, J15, J16, J17, J18: Conn_01x01_Pin; PAD-2x4mm-SMD
R3, R8, R11, R14, R17: 220R; R_0805_2012Metric
R4, R7, R10, R13, R16: 10K; R_0805_2012Metric
R5, R6, R9, R12, R15: 100R; R_0805_2012Metric
U2, U3, U4, U5, U6: RPR-220; RPR220; Manufacturer_Part_Number RPR-220; Mouser Part Number 755-RPR-220

Connections:
+3V3: J3.1, J15.1, R4.2, R7.2, R10.2, R13.2, R16.2
+5V: C1.1, J13.1, J16.1, R3.1, R8.1, R11.1, R14.1, R17.1
GND: C1.2, J14.1, J17.1, R5.2, R6.2, R9.2, R12.2, R15.2, U2.2 (K), U3.2 (K), U4.2 (K), U5.2 (K), U6.2 (K)
unnamed: R3.2, U2.1 (A)
unnamed: R5.1, U2.3 (E)
unnamed: R6.1, U3.3 (E)
unnamed: R8.2, U3.1 (A)
unnamed: R9.1, U4.3 (E)
unnamed: R11.2, U4.1 (A)
unnamed: R12.1, U5.3 (E)
unnamed: R14.2, U5.1 (A)
unnamed: R15.1, U6.3 (E)
unnamed: R17.2, U6.1 (A)
s1: J2.1, R4.1, U2.4 (C)
s2: J10.1, R7.1, U3.4 (C)
s3: J11.1, R10.1, U4.4 (C)
s4: J12.1, R13.1, U5.4 (C)
s5: J18.1, R16.1, U6.4 (C)
