SuperDuu/samsung-robot-2026/firmware/PidBoard/Core/Src/main.c

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
/* Includes ------------------------------------------------------------------*/
#include "main.h"

/* USER CODE BEGIN Includes */
#include "pid_controller.h"
#include "rs485_bus.h"
/* USER CODE END Includes */

TIM_HandleTypeDef htim1;
TIM_HandleTypeDef htim3;
TIM_HandleTypeDef htim14;

UART_HandleTypeDef huart2;
DMA_HandleTypeDef hdma_usart2_rx;
DMA_HandleTypeDef hdma_usart2_tx;

/* USER CODE BEGIN PV */
PID_Controller_t g_pid = {0};
RS485_Bus_t g_rs485 = {0};
/* USER CODE END PV */

void SystemClock_Config(void);
static void MX_GPIO_Init(void);
static void MX_DMA_Init(void);
static void MX_TIM1_Init(void);
static void MX_TIM3_Init(void);
static void MX_TIM14_Init(void);
static void MX_USART2_UART_Init(void);
/* USER CODE BEGIN PFP */
static void pid_apply_motor_outputs(uint8_t gate_enable, int32_t hw_duty_permille);
static void pid_handle_rx_frame(const RS485_Frame_t *frame, uint32_t now_ms);
static void pid_on_rs485_rx(RS485_Bus_t *bus, const RS485_Frame_t *frame, void *ctx);
static void pid_update_status_leds(uint32_t now_ms);
/* USER CODE END PFP */

/* USER CODE BEGIN 0 */
static void pid_apply_motor_outputs(uint8_t gate_enable, int32_t hw_duty_permille)
{
  if (gate_enable == 0U)
  {
    __HAL_TIM_SET_COMPARE(&htim1, TIM_CHANNEL_1, 0U);
    __HAL_TIM_SET_COMPARE(&htim1, TIM_CHANNEL_2, 0U);
    HAL_GPIO_WritePin(S_GPIO_Port, S_Pin, GPIO_PIN_RESET);
    HAL_GPIO_WritePin(S2_GPIO_Port, S2_Pin, GPIO_PIN_RESET);
    return;
  }

  /* Enable both IR2184 ~SD inputs; PWM duty is clamped <= 975 to guarantee bootstrap recharge */
  HAL_GPIO_WritePin(S_GPIO_Port, S_Pin, GPIO_PIN_SET);
  HAL_GPIO_WritePin(S2_GPIO_Port, S2_Pin, GPIO_PIN_SET);

  if (hw_duty_permille > 0)
  {
    uint32_t ccr = (uint32_t)hw_duty_permille;
    if (ccr > (uint32_t)PID_MAX_DUTY_PERMILLE)
    {
      ccr = (uint32_t)PID_MAX_DUTY_PERMILLE;
    }
    __HAL_TIM_SET_COMPARE(&htim1, TIM_CHANNEL_1, 0U);
    __HAL_TIM_SET_COMPARE(&htim1, TIM_CHANNEL_2, ccr);
  }
  else if (hw_duty_permille < 0)
  {
    uint32_t ccr = (uint32_t)(-hw_duty_permille);
    if (ccr > (uint32_t)PID_MAX_DUTY_PERMILLE)
    {
      ccr = (uint32_t)PID_MAX_DUTY_PERMILLE;
    }
    __HAL_TIM_SET_COMPARE(&htim1, TIM_CHANNEL_2, 0U);
    __HAL_TIM_SET_COMPARE(&htim1, TIM_CHANNEL_1, ccr);
  }
  else
  {
    /* Active low-side brake: both IN pins low while ~SD remains HIGH */
    __HAL_TIM_SET_COMPARE(&htim1, TIM_CHANNEL_1, 0U);
    __HAL_TIM_SET_COMPARE(&htim1, TIM_CHANNEL_2, 0U);
  }
}

static void pid_handle_rx_frame(const RS485_Frame_t *frame, uint32_t now_ms)
{
  if (frame == NULL)
  {
    return;
  }

  if (frame->msg_type == (uint8_t)RS485_MSG_MULTI_CMD)
  {
    RS485_MultiCmd_t multi;
    if (!RS485_DecodeMultiCmd(frame, &multi))
    {
      return;
    }

    uint8_t node_id = g_pid.cfg.node_id;
    uint8_t slot_idx = (node_id >= RS485_ADDR_SLAVE_MIN) ? (uint8_t)(node_id - 1U) : 0xFFU;
    bool need_telem = false;
    RS485_Telem_t telem = {0};

    uint32_t primask = __get_PRIMASK();
    __disable_irq();
    if ((multi.flags & RS485_CMD_FLAG_ESTOP) != 0U)
    {
      PID_ApplyCommand(&g_pid, RS485_WHEEL_DISABLED, 0, multi.flags, now_ms);
    }
    else if (slot_idx < multi.num_wheels)
    {
      PID_ApplyCommand(&g_pid,
                       (RS485_WheelMode_t)multi.wheels[slot_idx].mode,
                       (int32_t)multi.wheels[slot_idx].target,
                       multi.flags,
                       now_ms);
    }

    if (multi.poll_id == node_id)
    {
      PID_BuildTelem(&g_pid, &telem);
      need_telem = true;
    }
    if (primask == 0U)
    {
      __enable_irq();
    }

    if (need_telem)
    {
      (void)RS485_ScheduleTelemReply(&g_rs485, frame->src_id, &telem, now_ms);
    }
  }
  else if (frame->msg_type == (uint8_t)RS485_MSG_WHEEL_CMD)
  {
    RS485_WheelCmd_t wcmd;
    if (!RS485_DecodeWheelCmd(frame, &wcmd))
    {
      return;
    }

    RS485_Telem_t telem = {0};
    bool unicast = (frame->dst_id == g_pid.cfg.node_id);

    uint32_t primask = __get_PRIMASK();
    __disable_irq();
    PID_ApplyCommand(&g_pid, (RS485_WheelMode_t)wcmd.mode, wcmd.target, wcmd.flags, now_ms);
    if (unicast)
    {
      PID_BuildTelem(&g_pid, &telem);
    }
    if (primask == 0U)
    {
      __enable_irq();
    }

    if (unicast)
    {
      (void)RS485_ScheduleTelemReply(&g_rs485, frame->src_id, &telem, now_ms);
    }
  }
  else if (frame->msg_type == (uint8_t)RS485_MSG_CFG_CMD)
  {
    RS485_CfgCmd_t ccmd;
    if (!RS485_DecodeCfgCmd(frame, &ccmd))
    {
      return;
    }

    bool save_deferred = false;
    uint8_t status;
    uint8_t updated_id;

    uint32_t primask = __get_PRIMASK();
    __disable_irq();
    status = PID_HandleConfigSubcmd(&g_pid, &ccmd, &save_deferred);
    updated_id = g_pid.cfg.node_id;
    if (primask == 0U)
    {
      __enable_irq();
    }
    (void)save_deferred;

    RS485_SetLocalId(&g_rs485, updated_id);

    if (frame->dst_id != RS485_ADDR_BCAST)
    {
      RS485_CfgAck_t ack = {0};
      ack.node_id  = updated_id;
      ack.subcmd   = ccmd.subcmd;
      ack.status   = status;
      ack.reserved = 0U;
      (void)RS485_ScheduleCfgAckReply(&g_rs485, frame->src_id, &ack, now_ms);
    }
  }
}

static void pid_on_rs485_rx(RS485_Bus_t *bus, const RS485_Frame_t *frame, void *ctx)
{
  (void)ctx;
  if ((bus != NULL) && (frame != NULL))
  {
    pid_handle_rx_frame(frame, bus->last_rx_tick_ms);
  }
}

static void pid_update_status_leds(uint32_t now_ms)
{
  /* LED1 (PC15, active-LOW): solid ON when RS-485 bus active, 1 Hz blink when idle */
  bool link_alive = RS485_IsLinkAlive(&g_rs485, now_ms, PID_CMD_WATCHDOG_MS);
  GPIO_PinState led1_state = (link_alive || (((now_ms / 500U) & 1U) == 0U))
                               ? GPIO_PIN_RESET
                               : GPIO_PIN_SET;
  HAL_GPIO_WritePin(LED1_GPIO_Port, LED1_Pin, led1_state);

  /* LED2 (PC14, active-LOW): ON on E-STOP / watchdog / comm error / saturation, OFF when healthy */
  bool fault_or_sat = (g_pid.watchdog_tripped != 0U) ||
                      (g_pid.estop_latched != 0U) ||
                      (g_pid.comm_err_latched != 0U) ||
                      (g_pid.saturated != 0U);
  HAL_GPIO_WritePin(LED2_GPIO_Port, LED2_Pin, fault_or_sat ? GPIO_PIN_RESET : GPIO_PIN_SET);
}
/* USER CODE END 0 */

/**
  * @brief  The application entry point.
  * @retval int
  */
int main(void)
{

  /* MCU Configuration--------------------------------------------------------*/

  /* Reset of all peripherals, Initializes the Flash interface and the Systick. */
  HAL_Init();

  /* Configure the system clock */
  SystemClock_Config();

  /* Initialize all configured peripherals */
  MX_GPIO_Init();
  MX_DMA_Init();
  MX_TIM1_Init();
  MX_TIM3_Init();
  MX_TIM14_Init();
  MX_USART2_UART_Init();
  /* USER CODE BEGIN 2 */
  __HAL_TIM_SET_COMPARE(&htim1, TIM_CHANNEL_1, 0U);
  __HAL_TIM_SET_COMPARE(&htim1, TIM_CHANNEL_2, 0U);
  HAL_GPIO_WritePin(S_GPIO_Port, S_Pin, GPIO_PIN_RESET);
  HAL_GPIO_WritePin(S2_GPIO_Port, S2_Pin, GPIO_PIN_RESET);
  HAL_GPIO_WritePin(RE_DE_GPIO_Port, RE_DE_Pin, GPIO_PIN_RESET);

  if (HAL_TIM_PWM_Start(&htim1, TIM_CHANNEL_1) != HAL_OK)
  {
    Error_Handler();
  }
  if (HAL_TIM_PWM_Start(&htim1, TIM_CHANNEL_2) != HAL_OK)
  {
    Error_Handler();
  }
  if (HAL_TIM_Encoder_Start(&htim3, TIM_CHANNEL_ALL) != HAL_OK)
  {
    Error_Handler();
  }

  PID_Init(&g_pid, (uint16_t)__HAL_TIM_GET_COUNTER(&htim3), HAL_GetTick());

  RS485_Init(&g_rs485, &huart2, RE_DE_GPIO_Port, RE_DE_Pin, g_pid.cfg.node_id);
  RS485_SetRxCallback(&g_rs485, pid_on_rs485_rx, NULL);
  if (RS485_StartRx(&g_rs485) != HAL_OK)
  {
    Error_Handler();
  }

  if (HAL_TIM_Base_Start_IT(&htim14) != HAL_OK)
  {
    Error_Handler();
  }
  uint32_t seen_uart_errs = g_rs485.stats.uart_err_recoveries;
  /* USER CODE END 2 */

  /* Infinite loop */
  /* USER CODE BEGIN WHILE */
  while (1)
  {
    /* USER CODE END WHILE */

    /* USER CODE BEGIN 3 */
    uint32_t now_ms = HAL_GetTick();

    RS485_ProcessRx(&g_rs485, now_ms);

    uint32_t err_cnt = g_rs485.stats.uart_err_recoveries;
    if (err_cnt != seen_uart_errs)
    {
      seen_uart_errs = err_cnt;
      uint32_t primask = __get_PRIMASK();
      __disable_irq();
      g_pid.comm_err_latched = 1U;
      if (primask == 0U)
      {
        __enable_irq();
      }
    }

    RS485_TickMs(&g_rs485, now_ms);

    if ((g_pid.pending_flash_save != 0U) &&
        (g_rs485.pending_reply_valid == 0U) &&
        (g_rs485.tx_active == 0U) &&
        (huart2.gState == HAL_UART_STATE_READY))
    {
      (void)HAL_TIM_Base_Stop_IT(&htim14);
      pid_apply_motor_outputs(0U, 0);
      PID_ResetControlState(&g_pid);
      g_pid.mode = RS485_WHEEL_DISABLED;
      (void)PID_SaveConfigFlash(&g_pid);
      g_pid.pending_flash_save = 0U;
      RS485_SetLocalId(&g_rs485, g_pid.cfg.node_id);
      (void)HAL_TIM_Base_Start_IT(&htim14);
    }

    pid_update_status_leds(now_ms);
  }
  /* USER CODE END 3 */
}

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
/* USER CODE BEGIN 4 */
void HAL_TIM_PeriodElapsedCallback(TIM_HandleTypeDef *htim)
{
  if (htim->Instance == TIM14)
  {
    uint16_t hw_cnt = (uint16_t)__HAL_TIM_GET_COUNTER(&htim3);
    PID_Step1kHz(&g_pid, hw_cnt, HAL_GetTick());
    pid_apply_motor_outputs(g_pid.gate_enable, g_pid.hw_duty_permille);
  }
}

void HAL_UART_TxCpltCallback(UART_HandleTypeDef *huart)
{
  RS485_TxCpltCallback(&g_rs485, huart);
}

void HAL_UART_ErrorCallback(UART_HandleTypeDef *huart)
{
  RS485_UartErrorCallback(&g_rs485, huart);
}
/* USER CODE END 4 */
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
