SuperDuu/samsung-robot-2026/firmware/MainRB2/MainRB2.ioc

Mcu.UserName=STM32F405RGTx
PA0-WKUP.Signal=ADCx_IN0
PA1.GPIO_Label=RE_DE
PA1.Signal=GPIO_Output
PA10.Signal=USART1_RX
PA11.Signal=USB_OTG_FS_DM
PA12.Signal=USB_OTG_FS_DP
PA13.Signal=SYS_JTMS-SWDIO
PA14.Signal=SYS_JTCK-SWCLK
PA15.GPIO_Label=SW2
PA15.Signal=GPIO_Input
PA2.Signal=USART2_TX
PA3.Signal=USART2_RX
PA4.GPIO_Label=MH_CS
PA4.Signal=GPIO_Output
PA5.Signal=SPI1_SCK
PA7.Signal=SPI1_MOSI
PA8.Signal=I2C3_SCL
PA9.Signal=USART1_TX
PB0.Signal=S_TIM3_CH3
PB1.Signal=S_TIM3_CH4
PB10.Signal=I2C2_SCL
PB11.Signal=I2C2_SDA
PB12.GPIO_Label=SW1
PB12.Signal=GPIO_Input
PB13.GPIO_Label=LS4
PB13.Signal=GPIO_Output
PB14.Signal=S_TIM12_CH1
PB15.Signal=S_TIM12_CH2
PB2.GPIO_Label=L11
PB2.Signal=GPIO_Output
PB3.GPIO_Label=L8
PB3.Signal=GPIO_Output
PB4.GPIO_Label=L7
PB4.Signal=GPIO_Output
PB5.GPIO_Label=L6
PB5.Signal=GPIO_Output
PB6.GPIO_Label=L5
PB6.Signal=GPIO_Output
PB7.GPIO_Label=L4
PB7.Signal=GPIO_Output
PB8.Signal=S_TIM4_CH3
PB9.Signal=S_TIM4_CH4
PC0.GPIO_Label=s3
PC0.Signal=GPIO_Output
PC1.GPIO_Label=s2
PC1.Signal=GPIO_Output
PC10.Signal=UART4_TX
PC11.Signal=UART4_RX
PC12.GPIO_Label=L10
PC12.Signal=GPIO_Output
PC13-ANTI_TAMP.GPIO_Label=L3
PC13-ANTI_TAMP.Signal=GPIO_Output
PC14-OSC32_IN.GPIO_Label=L2
PC14-OSC32_IN.Signal=GPIO_Output
PC15-OSC32_OUT.GPIO_Label=L1
PC15-OSC32_OUT.Signal=GPIO_Output
PC2.GPIO_Label=s1
PC2.Signal=GPIO_Output
PC3.GPIO_Label=s0
PC3.Signal=GPIO_Output
PC4.GPIO_Label=MH_RST
PC4.Signal=GPIO_Output
PC5.GPIO_Label=MH_DC
PC5.Signal=GPIO_Output
PC6.GPIO_Label=LS3
PC6.Signal=GPIO_Output
PC7.GPIO_Label=LS2
PC7.Signal=GPIO_Output
PC8.GPIO_Label=LS1
PC8.Signal=GPIO_Output
PC9.Signal=I2C3_SDA
PD2.GPIO_Label=L9
PD2.Signal=GPIO_Output
PH0-OSC_IN.Signal=RCC_OSC_IN
PH1-OSC_OUT.Signal=RCC_OSC_OUT
