SuperDuu/samsung-robot-2026/firmware/MainRB2/Core/Src/main.c

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
/* Includes ------------------------------------------------------------------*/
#include "main.h"

/* USER CODE BEGIN Includes */
#include "cd4067.h"
#include "bno055.h"
#include "bno055_stm32.h"
#include "servo.h"
#include "buttons.h"
#include "rf_hc12.h"
#include "rs485_bus.h"
#include "drive_kinematics.h"
/* USER CODE END Includes */

/* USER CODE BEGIN PTD */
typedef enum
{
  MAINRB2_DRIVE_IDLE        = 0U,
  MAINRB2_DRIVE_MANUAL_VEL  = 1U,
  MAINRB2_DRIVE_LINE_FOLLOW = 2U
} MainRB2_DriveMode_t;
/* USER CODE END PTD */

/* USER CODE BEGIN PD */
#define RS485_TX_PERIOD_MS      10U
#define RS485_WHEEL_TIMEOUT_MS  250U
/* USER CODE END PD */

ADC_HandleTypeDef hadc1;
DMA_HandleTypeDef hdma_adc1;

I2C_HandleTypeDef hi2c2;
I2C_HandleTypeDef hi2c3;

SPI_HandleTypeDef hspi1;

TIM_HandleTypeDef htim3;
TIM_HandleTypeDef htim4;
TIM_HandleTypeDef htim7;
TIM_HandleTypeDef htim12;

UART_HandleTypeDef huart4;
UART_HandleTypeDef huart1;
UART_HandleTypeDef huart2;
DMA_HandleTypeDef hdma_uart4_rx;
DMA_HandleTypeDef hdma_uart4_tx;
DMA_HandleTypeDef hdma_usart2_rx;
DMA_HandleTypeDef hdma_usart2_tx;

PCD_HandleTypeDef hpcd_USB_OTG_FS;

/* USER CODE BEGIN PV */
BNO055_IMU_t g_imu = {0};
RF_HC12_t g_rf = {0};
RF_PayloadManualToAuto_t g_manual_msg = {0};
bool g_manual_link_ok = false;
uint8_t g_front_mask = 0U;
uint8_t g_rear_mask = 0U;
int16_t g_front_error = 0;
int16_t g_rear_error = 0;
RS485_Bus_t g_rs485 = {0};
RS485_Telem_t g_wheel_telem[DRIVE_DIFF_WHEEL_COUNT] = {0};
bool g_wheel_alive[DRIVE_DIFF_WHEEL_COUNT] = {false};
static uint32_t g_wheel_rx_ms[DRIVE_DIFF_WHEEL_COUNT] = {0};
static bool g_wheel_seen[DRIVE_DIFF_WHEEL_COUNT] = {false};
static uint8_t g_rs485_poll_idx = 0U;
static uint32_t g_last_rs485_tx_ms = 0U;
static MainRB2_DriveMode_t g_drive_mode = MAINRB2_DRIVE_IDLE;
static int16_t g_cmd_linear_rpm_x10 = 0;
static int16_t g_cmd_angular_rpm_x10 = 0;
static int16_t g_line_base_rpm_x10 = 0;
static Drive_LineFollowState_t g_line_state = {0};
static const Drive_LineGains_t g_line_gains =
{
  DRIVE_LINE_KP_DEFAULT,
  DRIVE_LINE_KD_DEFAULT,
  DRIVE_LINE_LOSS_TIMEOUT_MS,
  DRIVE_DEFAULT_MAX_RPMX10
};
static bool g_estop_latched = false;
static bool g_clear_faults_pending = false;
static uint32_t g_last_imu_tick_ms = 0U;
/* USER CODE END PV */

void SystemClock_Config(void);
static void MX_GPIO_Init(void);
static void MX_DMA_Init(void);
static void MX_ADC1_Init(void);
static void MX_I2C2_Init(void);
static void MX_I2C3_Init(void);
static void MX_SPI1_Init(void);
static void MX_USART1_UART_Init(void);
static void MX_USART2_UART_Init(void);
static void MX_UART4_Init(void);
static void MX_USB_OTG_FS_PCD_Init(void);
static void MX_TIM3_Init(void);
static void MX_TIM12_Init(void);
static void MX_TIM4_Init(void);
static void MX_TIM7_Init(void);
/* USER CODE BEGIN PFP */
static void main_on_rs485_rx(RS485_Bus_t *bus, const RS485_Frame_t *frame, void *ctx);
/* USER CODE END PFP */

/* USER CODE BEGIN 0 */
static void main_on_rs485_rx(RS485_Bus_t *bus, const RS485_Frame_t *frame, void *ctx)
{
  (void)ctx;
  if ((bus == NULL) || (frame == NULL))
  {
    return;
  }

  if (frame->msg_type == (uint8_t)RS485_MSG_TELEM)
  {
    RS485_Telem_t telem;
    if (RS485_DecodeTelem(frame, &telem) &&
        (telem.node_id >= RS485_ADDR_SLAVE_MIN) &&
        (telem.node_id <= DRIVE_DIFF_WHEEL_COUNT))
    {
      uint8_t idx = (uint8_t)(telem.node_id - 1U);
      g_wheel_telem[idx] = telem;
      g_wheel_rx_ms[idx] = bus->last_rx_tick_ms;
      g_wheel_seen[idx] = true;
    }
  }
}

void MainRB2_SetDriveCommand(int16_t linear_rpm_x10, int16_t angular_rpm_x10)
{
  g_cmd_linear_rpm_x10 = linear_rpm_x10;
  g_cmd_angular_rpm_x10 = angular_rpm_x10;
  g_drive_mode = ((linear_rpm_x10 == 0) && (angular_rpm_x10 == 0))
                   ? MAINRB2_DRIVE_IDLE
                   : MAINRB2_DRIVE_MANUAL_VEL;
}

void MainRB2_EnableLineFollow(bool enable, int16_t base_rpm_x10)
{
  if (enable)
  {
    if (g_drive_mode != MAINRB2_DRIVE_LINE_FOLLOW)
    {
      Drive_LineFollowReset(&g_line_state);
    }
    g_line_base_rpm_x10 = base_rpm_x10;
    g_drive_mode = MAINRB2_DRIVE_LINE_FOLLOW;
  }
  else
  {
    g_drive_mode = MAINRB2_DRIVE_IDLE;
    g_line_base_rpm_x10 = 0;
    g_cmd_linear_rpm_x10 = 0;
    g_cmd_angular_rpm_x10 = 0;
    Drive_LineFollowReset(&g_line_state);
  }
}

void MainRB2_SetEstop(bool estop)
{
  g_estop_latched = estop;
  if (estop)
  {
    g_cmd_linear_rpm_x10 = 0;
    g_cmd_angular_rpm_x10 = 0;
    Drive_LineFollowReset(&g_line_state);
    Servo_StopAll360();
  }
}

void MainRB2_ClearWheelFaults(void)
{
  g_estop_latched = false;
  g_clear_faults_pending = true;
}
/* USER CODE END 0 */

/**
  * @brief  The application entry point.
  * @retval int
  */
int main(void)
{

  /* MCU Configuration--------------------------------------------------------*/

  /* Reset of all peripherals, Initializes the Flash interface and the Systick. */
  HAL_Init();

  /* Configure the system clock */
  SystemClock_Config();

  /* Initialize all configured peripherals */
  MX_GPIO_Init();
  MX_DMA_Init();
  MX_ADC1_Init();
  MX_I2C2_Init();
  MX_I2C3_Init();
  MX_SPI1_Init();
  MX_USART1_UART_Init();
  MX_USART2_UART_Init();
  MX_UART4_Init();
  MX_USB_OTG_FS_PCD_Init();
  MX_TIM3_Init();
  MX_TIM12_Init();
  MX_TIM4_Init();
  MX_TIM7_Init();
  /* USER CODE BEGIN 2 */
  /* Half-duplex RS-485 Master on USART2 + PA1 RE/DE for 2 diff wheels (PidBoard IDs 1..2) */
  RS485_Init(&g_rs485, &huart2, RE_DE_GPIO_Port, RE_DE_Pin, RS485_ADDR_MASTER);
  RS485_SetRxCallback(&g_rs485, main_on_rs485_rx, NULL);
  if (RS485_StartRx(&g_rs485) != HAL_OK)
  {
    Error_Handler();
  }
  Drive_LineFollowReset(&g_line_state);

  /* Autonomous 2x8 dual-end line array on CD4067 (Front = I0..I7, Rear = I8..I15)
   * with 11-LED L1..L11 encoding (default AUTO_ALT 600ms Front/Rear + summary LEDs L9..L11). */
  CD4067_Init(&hadc1, &htim7);
  if (CD4067_StartLine2x8(CD4067_DEFAULT_THRESHOLD) != HAL_OK)
  {
    Error_Handler();
  }

  /* Onboard switches SW1 (PB12) & SW2 (PA15): external +5V/+3V3 FT-safe inputs */
  Buttons_Init(true, true);

  /* Dual-mode servo driver across 6 PWM channels (CH1..3 = 0-270 deg, CH4..6 = 360 continuous) */
  if (Servo_Init(&htim3, &htim4, &htim12) != HAL_OK)
  {
    Error_Handler();
  }
  (void)Servo_Config270(SERVO_CH_1, SERVO_PWM_MIN_US, SERVO_PWM_MAX_US, false);
  (void)Servo_Config270(SERVO_CH_2, SERVO_PWM_MIN_US, SERVO_PWM_MAX_US, false);
  (void)Servo_Config270(SERVO_CH_3, SERVO_PWM_MIN_US, SERVO_PWM_MAX_US, false);
  (void)Servo_Config360(SERVO_CH_4, SERVO_PWM_NEUTRAL_US, SERVO_360_DEFAULT_HALF_SPAN_US,
                        SERVO_DEFAULT_DEADBAND_PCT, false);
  (void)Servo_Config360(SERVO_CH_5, SERVO_PWM_NEUTRAL_US, SERVO_360_DEFAULT_HALF_SPAN_US,
                        SERVO_DEFAULT_DEADBAND_PCT, false);
  (void)Servo_Config360(SERVO_CH_6, SERVO_PWM_NEUTRAL_US, SERVO_360_DEFAULT_HALF_SPAN_US,
                        SERVO_DEFAULT_DEADBAND_PCT, false);

  /* HC-12 RF link (Autonomous Robot = RF_NODE_AUTO):
   * STRICT source whitelist = RF_SRC_MASK(RF_NODE_MANUAL) ONLY.
   * Frames from RF_NODE_TDK (handheld controller) are rejected and discarded. */
  RF_HC12_Init(&g_rf, &huart4, NULL, 0U, RF_NODE_AUTO, RF_SRC_MASK(RF_NODE_MANUAL));
  (void)RF_HC12_SetupRoutine(&g_rf, RF_HC12_DEFAULT_CHANNEL, RF_HC12_DEFAULT_BAUD);
  if (RF_HC12_StartRx(&g_rf) != HAL_OK)
  {
    Error_Handler();
  }

  /* Wait for BNO055 POR (up to 750 ms) and start NDOF fusion on I2C3 (PA8/PC9) */
  BNO055_IMU_Init(&g_imu, &hi2c3);
  g_last_imu_tick_ms = HAL_GetTick();
  g_last_rs485_tx_ms = g_last_imu_tick_ms;
  /* USER CODE END 2 */

  /* Infinite loop */
  /* USER CODE BEGIN WHILE */
  while (1)
  {
    /* USER CODE END WHILE */

    /* USER CODE BEGIN 3 */
    uint32_t now_ms = HAL_GetTick();
    RF_Frame_t rx_frame;

    /* 1. Drain UART4 circular DMA RX; strictly accepts RF_NODE_MANUAL, blocks RF_NODE_TDK */
    RF_HC12_ProcessRx(&g_rf, now_ms);
    if (RF_HC12_PopLatestFrame(&g_rf, &rx_frame))
    {
      (void)RF_HC12_DecodeManualToAuto(&rx_frame, &g_manual_msg);
    }

    g_manual_link_ok = RF_HC12_IsLinkAlive(&g_rf, now_ms, RF_HC12_DEFAULT_TIMEOUT_MS);
    if (!g_manual_link_ok)
    {
      Servo_StopAll360();
    }

    /* 2. Drain USART2 RS-485 DMA RX telemetry & maintain wheel liveness */
    RS485_ProcessRx(&g_rs485, now_ms);
    RS485_TickMs(&g_rs485, now_ms);
    for (uint8_t i = 0U; i < DRIVE_DIFF_WHEEL_COUNT; i++)
    {
      g_wheel_alive[i] = g_wheel_seen[i] &&
                         ((uint32_t)(now_ms - g_wheel_rx_ms[i]) <= RS485_WHEEL_TIMEOUT_MS);
    }

    /* 3. SW1 cycles 11-LED 2x8 view mode; SW2 recalibrates 16 line sensors + clears faults */
    Buttons_Update(now_ms);
    if (Buttons_ConsumePressed(BTN_SW1))
    {
      (void)CD4067_CycleLedViewMode();
    }
    if (Buttons_ConsumePressed(BTN_SW2))
    {
      CD4067_StartCalibration();
      MainRB2_ClearWheelFaults();
    }

    /* 4. Snapshot Front (I0..I7) and Rear (I8..I15) line state & drive L1..L11 */
    g_front_mask  = CD4067_GetFrontMask();
    g_rear_mask   = CD4067_GetRearMask();
    g_front_error = CD4067_GetFrontError();
    g_rear_error  = CD4067_GetRearError();
    CD4067_UpdateLeds(now_ms);

    /* 5. 100 Hz (10 ms) 2-wheel differential drive kinematics & RS-485 TDMA poll (IDs 1..2) */
    if ((uint32_t)(now_ms - g_last_rs485_tx_ms) >= RS485_TX_PERIOD_MS)
    {
      g_last_rs485_tx_ms = now_ms;

      uint8_t modes[DRIVE_DIFF_WHEEL_COUNT] = {0};
      int16_t targets[DRIVE_DIFF_WHEEL_COUNT] = {0};

      if (g_drive_mode == MAINRB2_DRIVE_LINE_FOLLOW)
      {
        uint8_t active_mask = (g_line_base_rpm_x10 >= 0) ? g_front_mask : g_rear_mask;
        int16_t line_err    = (g_line_base_rpm_x10 >= 0) ? g_front_error : g_rear_error;
        Drive_LineFollowStep(&g_line_state,
                             &g_line_gains,
                             CD4067_IsCalibrated(),
                             g_line_base_rpm_x10,
                             active_mask,
                             line_err,
                             now_ms,
                             g_estop_latched,
                             modes,
                             targets);
      }
      else if (g_drive_mode == MAINRB2_DRIVE_MANUAL_VEL)
      {
        Drive_DiffCompute(g_cmd_linear_rpm_x10,
                          g_cmd_angular_rpm_x10,
                          DRIVE_DEFAULT_MAX_RPMX10,
                          g_estop_latched,
                          modes,
                          targets);
      }
      else
      {
        /* Boot default MAINRB2_DRIVE_IDLE: hold active brake without moving off manual RF traffic */
        Drive_DiffCompute(0, 0, DRIVE_DEFAULT_MAX_RPMX10, g_estop_latched, modes, targets);
      }

      RS485_MultiCmd_t mcmd = {0};
      mcmd.num_wheels = DRIVE_DIFF_WHEEL_COUNT;
      mcmd.poll_id    = (uint8_t)(g_rs485_poll_idx + 1U);
      g_rs485_poll_idx = (uint8_t)((g_rs485_poll_idx + 1U) % DRIVE_DIFF_WHEEL_COUNT);
      mcmd.flags      = (g_estop_latched ? RS485_CMD_FLAG_ESTOP : 0U) |
                        (g_clear_faults_pending ? RS485_CMD_FLAG_CLEAR_FAULTS : 0U);
      for (uint8_t i = 0U; i < DRIVE_DIFF_WHEEL_COUNT; i++)
      {
        mcmd.wheels[i].mode   = modes[i];
        mcmd.wheels[i].target = targets[i];
      }

      if (RS485_SendMultiCmd(&g_rs485, &mcmd, now_ms) == HAL_OK)
      {
        g_clear_faults_pending = false;
      }
    }

    /* 6. Poll BNO055 at 100 Hz (10 ms) */
    if ((uint32_t)(now_ms - g_last_imu_tick_ms) >= 10U)
    {
      g_last_imu_tick_ms = now_ms;
      if (g_imu.connected)
      {
        BNO055_IMU_Update(&g_imu);
      }
    }
  }
  /* USER CODE END 3 */
}

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
/* USER CODE BEGIN 4 */
void HAL_TIM_PeriodElapsedCallback(TIM_HandleTypeDef *htim)
{
  CD4067_TIM_PeriodElapsedCallback(htim);
}

void HAL_ADC_ConvCpltCallback(ADC_HandleTypeDef *hadc)
{
  CD4067_ADC_ConvCpltCallback(hadc);
}

void HAL_UART_TxCpltCallback(UART_HandleTypeDef *huart)
{
  RS485_TxCpltCallback(&g_rs485, huart);
}

void HAL_UART_ErrorCallback(UART_HandleTypeDef *huart)
{
  RF_HC12_UartErrorCallback(&g_rf, huart);
  RS485_UartErrorCallback(&g_rs485, huart);
}
/* USER CODE END 4 */
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
