SuperDuu/samsung-robot-2026/(commit log)

2026-10-01 First Commit: Inital Schematic and Requirements
2026-10-13 Schematic Update
2026-10-13 add pcb line
2026-10-13 add pcb
2026-10-30 add main schematic
2026-10-30 add main pcb
2026-10-30 add board artifacts
2026-10-30 add gerber file
2026-10-30 add tdk pcb
2026-10-31 add bom
2026-10-31 change dir pcb & add CAD folder
2026-11-11 update kicad metadata
2026-11-11 add tdk interrupts
2026-11-11 implement tdk interrupts
2026-11-11 add ps2 driver
2026-11-11 add rf driver
2026-11-11 add tdk drivers
2026-11-11 add main interrupts
2026-11-11 implement main interrupts
2026-11-11 add bno055 driver
2026-11-11 add imu bridge
2026-11-11 implement imu i2c
2026-11-11 add mux driver
2026-11-11 add hc12 driver
2026-11-11 add servo header
2026-11-11 add servo driver
2026-11-11 add buttons header
2026-11-11 add buttons driver
2026-11-11 add kinematics header
2026-11-11 add omni kinematics
2026-11-11 add main drivers
2026-11-11 add auto interrupts
2026-11-11 implement auto interrupts
2026-11-11 add imu adapter
2026-11-11 implement imu adapter
2026-11-11 add auto servo
2026-11-11 implement auto servo
2026-11-11 add auto buttons
2026-11-11 implement auto buttons
2026-11-11 add auto kinematics
2026-11-11 add diff kinematics
2026-11-11 add auto drivers
2026-11-11 configure pid ioc
2026-11-11 reserve pid flash
2026-11-11 add pid build
2026-11-11 configure pid hal
2026-11-11 add pid interrupts
2026-11-11 implement pid interrupts
2026-11-11 configure pid msp
2026-11-11 add pid sysinit
2026-11-11 add pid pins
2026-11-11 add pid header
2026-11-11 add pid controller
2026-11-11 add pid rs485
2026-11-11 implement pid rs485
2026-11-11 implement pid firmware
2026-11-11 add pid drivers
