SuperDuu/samsung-robot-2026/(notices)

Notices in the files:
firmware/MainRB2/Core/Src/main.c:
Copyright (c) 2026 STMicroelectronics.
All rights reserved.
This software is licensed under terms that can be found in the LICENSE file
